lucy-chapar/finder-puck/docs/case-back.png

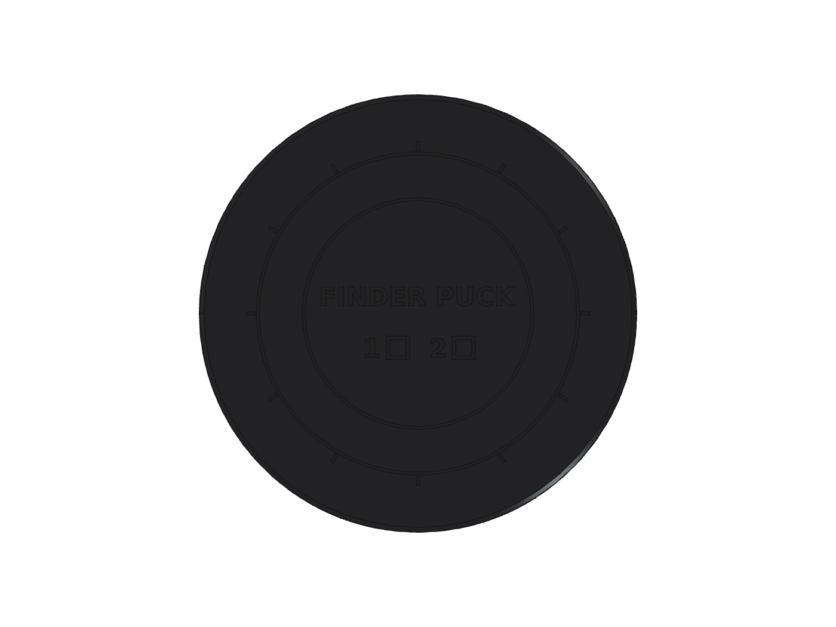
docs/case-back.png
