lucy-chapar/finder-puck/docs/case-face.png

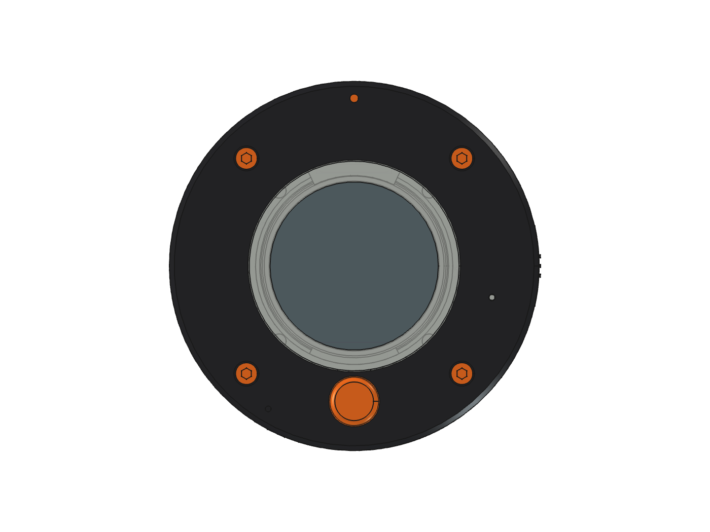
docs/case-face.png
