lucy-chapar/finder-puck/docs/case-shell.png

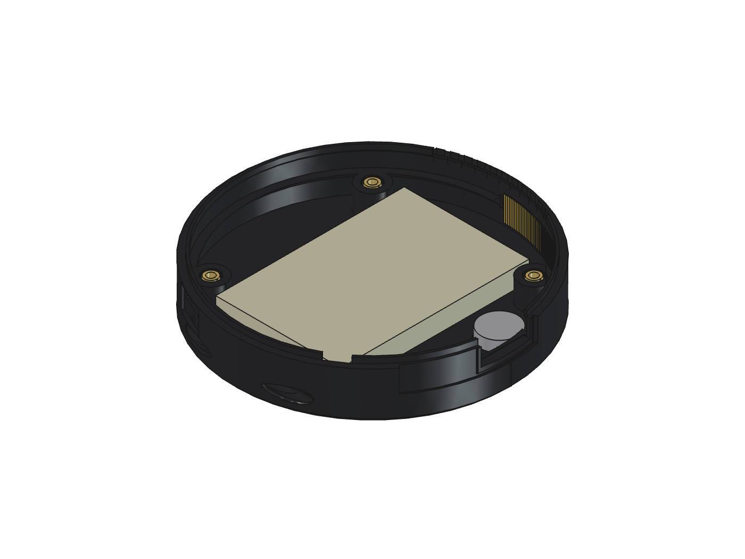
docs/case-shell.png
