lucy-chapar/finder-puck/docs/case-side.png

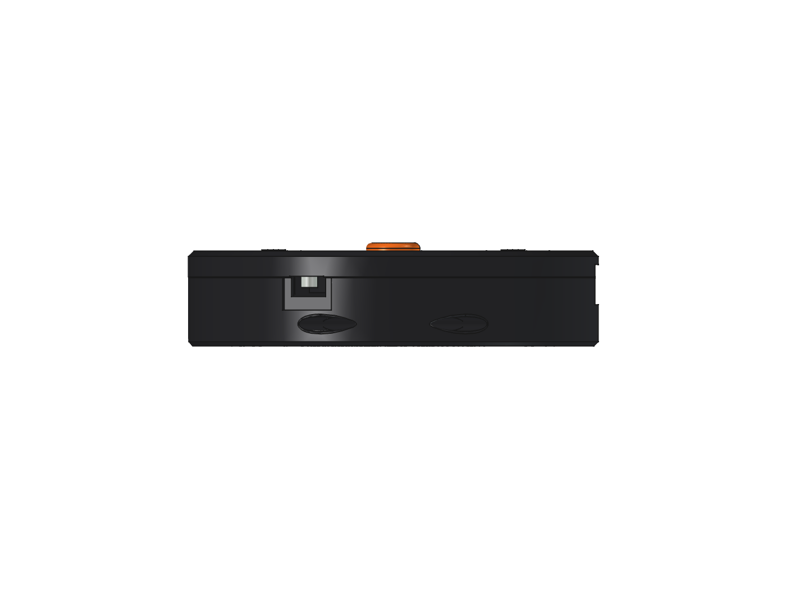
docs/case-side.png
