lucy-chapar/finder-puck/docs/case-stack.png

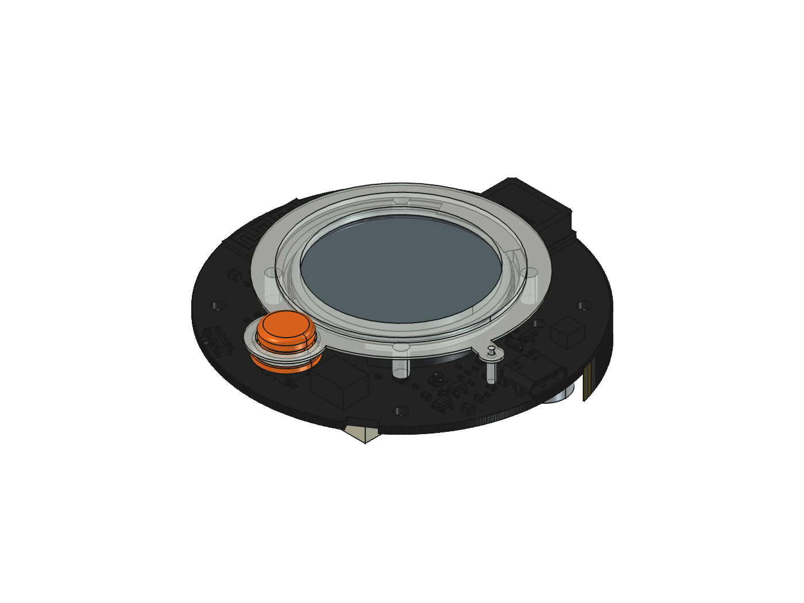
docs/case-stack.png
