lucy-chapar/finder-puck/docs/finder_puck_render_back.png

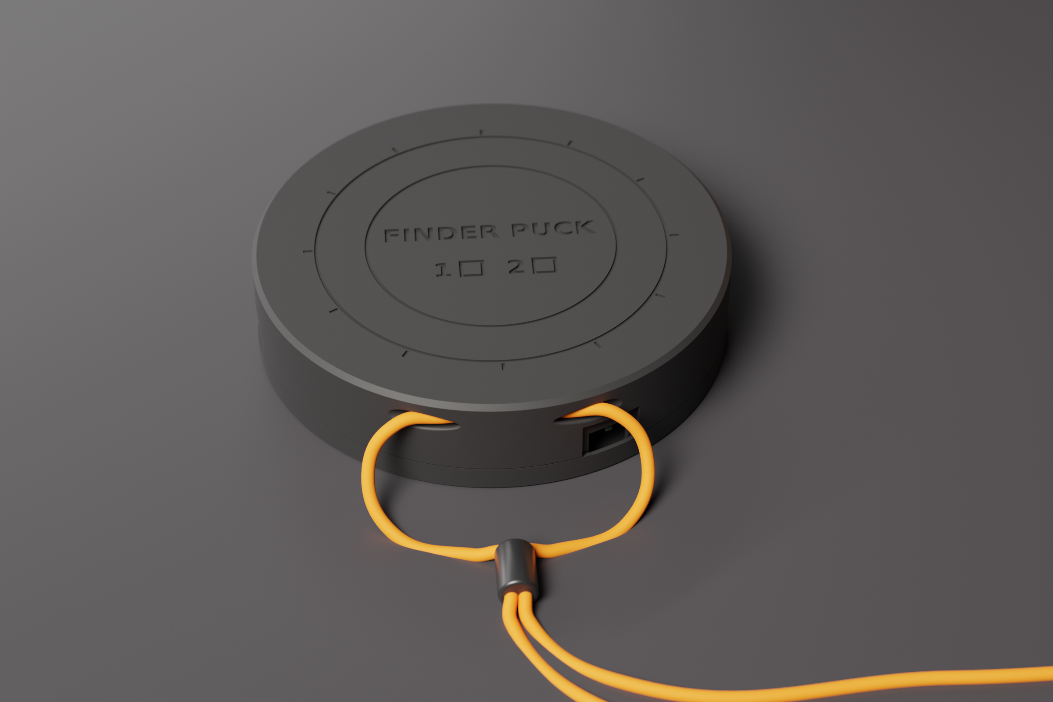
docs/finder_puck_render_back.png
