lucy-chapar/finder-puck/docs/pcb-back.png

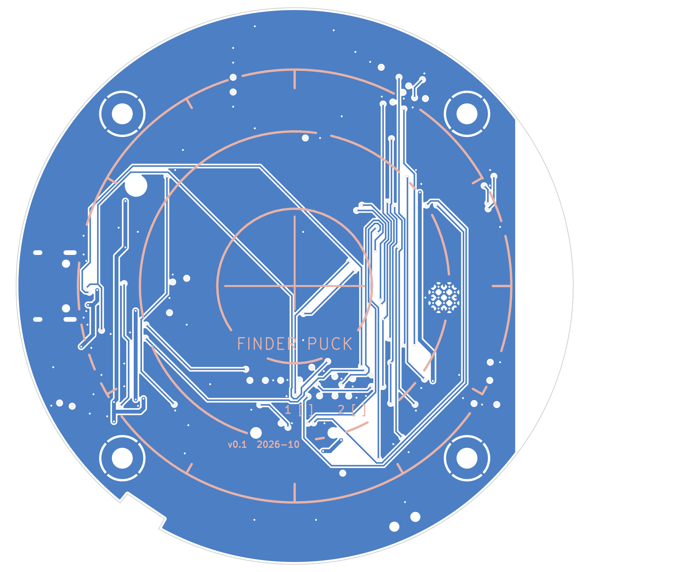
docs/pcb-back.png
