lucy-chapar/finder-puck/fab/finder_puck_bom.csv

Comment | Designator | Footprint | Quantity | Manufacturer part | LCSC Part #
1uF 10V X5R | C1 | C_0402_1005Metric | 1 | Samsung CL05A105KA5NQNC (25 V) | C52923
220nF 16V X7R | C13 | C_0402_1005Metric | 1 | Samsung CL05B224KO5NNNC | C16772
1uF 10V X5R | C17 | C_0603_1608Metric | 1 | Samsung CL10A105KB8NNNC (50 V) | C15849
10uF 10V X5R | C2,C7,C9,C15 | C_0805_2012Metric | 4 | Samsung CL21A106KAYNNNE (25 V) | C15850
100nF 16V X7R | C3,C8,C10,C11,C12,C14,C16,C18,C19,C20,C21,C22 | C_0402_1005Metric | 12 | Samsung CL05B104KO5NNNC | C1525
4.7uF 10V X5R | C4,C5,C6 | C_0603_1608Metric | 3 | Samsung CL10A475KO8NNNC (16 V) | C19666
1N4148W | D1 | D_SOD-123 | 1 | 1N4148W | C81598
Red charge | D2 | LED_0603_1608Metric | 1 | Hubei KENTO KT-0603R | C2286
USB-C | J1 | USB_C_Receptacle_HRO_TYPE-C-31-M-12 | 1 | HRO TYPE-C-31-M-12 | C165948
LiPo 1S | J2 | JST_PH_S2B-PH-SM4-TB_1x02-1MP_P2.00mm_Horizontal | 1 | JST S2B-PH-SM4-TB | C295747
U.FL 915MHz | J4 | U.FL_Hirose_U.FL-R-SMT-1_Vertical | 1 | Hirose U.FL-R-SMT-1(10) | C88373
Vibration motor | J5 | JST_SH_SM02B-SRSS-TB_1x02-1MP_P1.00mm_Horizontal | 1 | JST SM02B-SRSS-TB | C160402
WS2812B-2020 | LED1,LED2,LED3,LED4 | LED_WS2812B-2020_PLCC4_2.0x2.0mm | 4 | Worldsemi WS2812B-2020-V6 | C52917434
AO3400A | Q1,Q2 | SOT-23 | 2 | AOS AO3400A | C20917
AO3401A | Q3 | SOT-23 | 1 | AOS AO3401A | C15127
10k | R1,R2,R16,R17,R23 | R_0402_1005Metric | 5 | UNI-ROYAL 0402WGF1002TCE | C25744
100 | R11 | R_0402_1005Metric | 1 | UNI-ROYAL 0402WGF1000TCE | C25076
27 | R13 | R_0805_2012Metric | 1 | UNI-ROYAL 0805W8F270JT5E | C17594
33 | R18,R19 | R_0402_1005Metric | 2 | UNI-ROYAL 0402WGF330JTCE | C25105
150k | R21,R26 | R_0402_1005Metric | 2 | UNI-ROYAL 0402WGF1503TCE | C25755
220 | R24 | R_0402_1005Metric | 1 | UNI-ROYAL 0402WGF2200TCE | C25091
4.7k | R3,R4 | R_0402_1005Metric | 2 | UNI-ROYAL 0402WGF4701TCE | C25900
5.1k | R5,R6 | R_0402_1005Metric | 2 | UNI-ROYAL 0402WGF5101TCE | C25905
3.3k | R7 | R_0402_1005Metric | 1 | UNI-ROYAL 0402WGF3301TCE | C25890
1k | R8,R14 | R_0402_1005Metric | 2 | UNI-ROYAL 0402WGF1001TCE | C11702
100k | R9,R10,R12,R15,R20,R22,R25 | R_0402_1005Metric | 7 | UNI-ROYAL 0402WGF1003TCE | C25741
Button (top, 5 mm stem) | SW1 | SW_SPST_PTS645 | 1 | C&K PTS645SL50SMTR92LFS | C221877
Power | SW2 | SW_SPDT_PCM12 | 1 | C&K PCM12SMTR | C221841
ESP32-S3-WROOM-1-N8 | U1 | ESP32-S3-WROOM-1 | 1 | Espressif ESP32-S3-WROOM-1-N8 | C2913198
RFM95W-915S2 | U2 | HOPERF_RFM9XW_SMD | 1 | HopeRF RFM95W-915S2
SAM-M10Q | U3 | ublox_SAM-M8Q | 1 | u-blox SAM-M10Q-00B | C5443880
LIS3DH | U4 | LGA-16_3x3mm_P0.5mm_LayoutBorder3x5y | 1 | ST LIS3DHTR | C15134
LIS2MDL | U5 | LGA-12_2x2mm_P0.5mm | 1 | ST LIS2MDLTR | C919695
MCP73831-2-OT | U6 | SOT-23-5 | 1 | Microchip MCP73831T-2ACI/OT | C424093
AP2112K-3.3 | U7 | SOT-23-5 | 1 | Diodes AP2112K-3.3TRG1 | C51118
