lucy-chapar/finder-puck/case/finder_puck_shell.stl

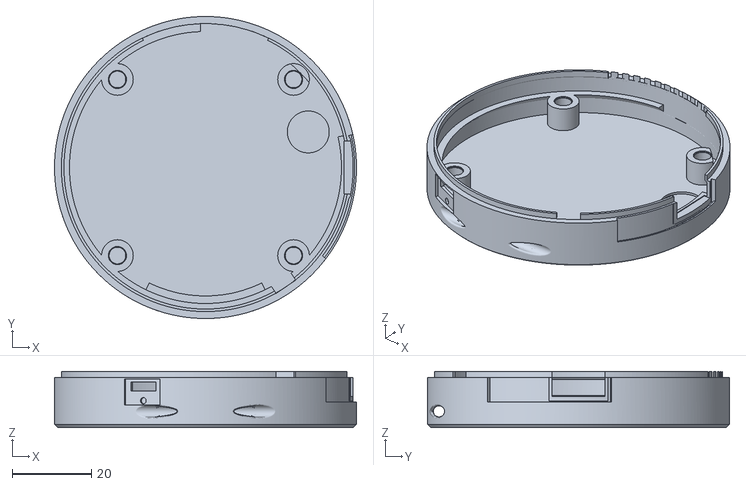
[picture p13: CAD file, 2026-10-23]
case/finder_puck_shell.stl
76.4 x 76.4 x 14.2
