lucy-chapar/finder-puck/mech/finder_puck.step

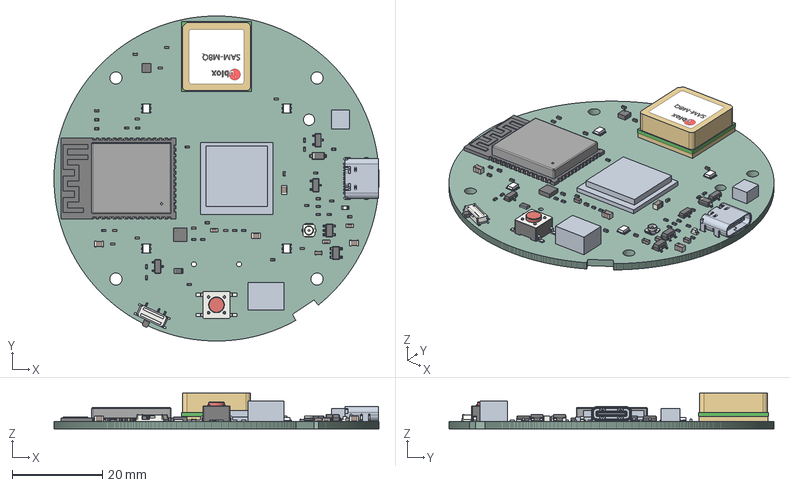
[picture p14: CAD file, 2026-10-23]
mech/finder_puck.step
72.0 x 72.0 x 7.95 mm
finder_puck PCB
