lucy-chapar/finder-puck/case/finder_puck_cap.stl

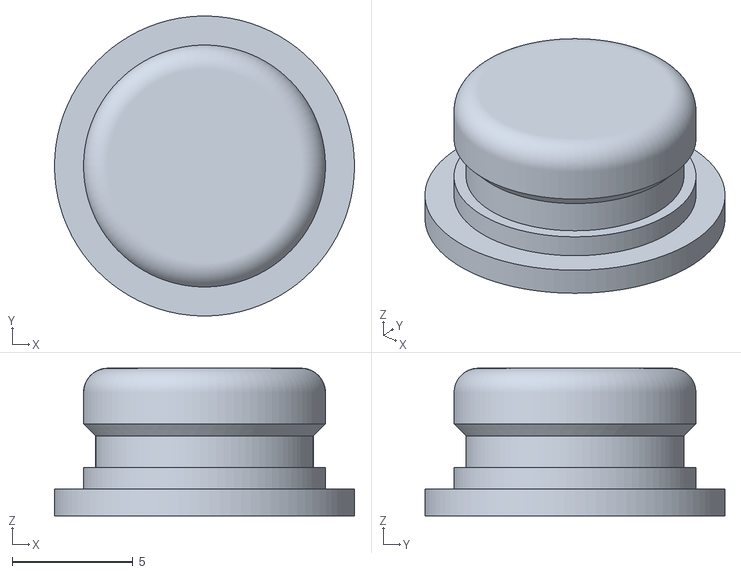
[picture p15: CAD file, 2026-10-23]
case/finder_puck_cap.stl
12.4 x 12.4 x 6.10
