lucy-chapar/finder-puck/case/finder_puck_case.step

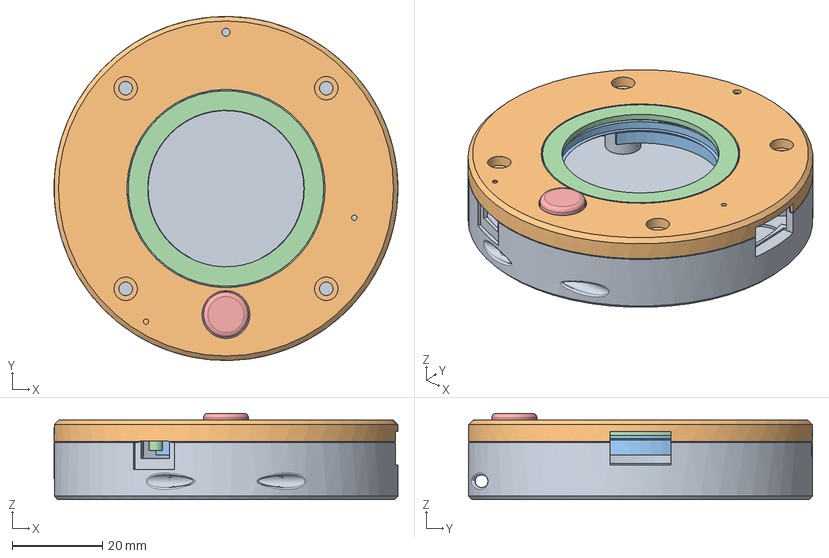
[picture p16: CAD file, 2026-10-23]
case/finder_puck_case.step
76.4 x 76.4 x 19.2 mm
Plate
Ring
Bezel
Cap
