lucy-chapar/finder-puck/case/finder_puck_ring.stl

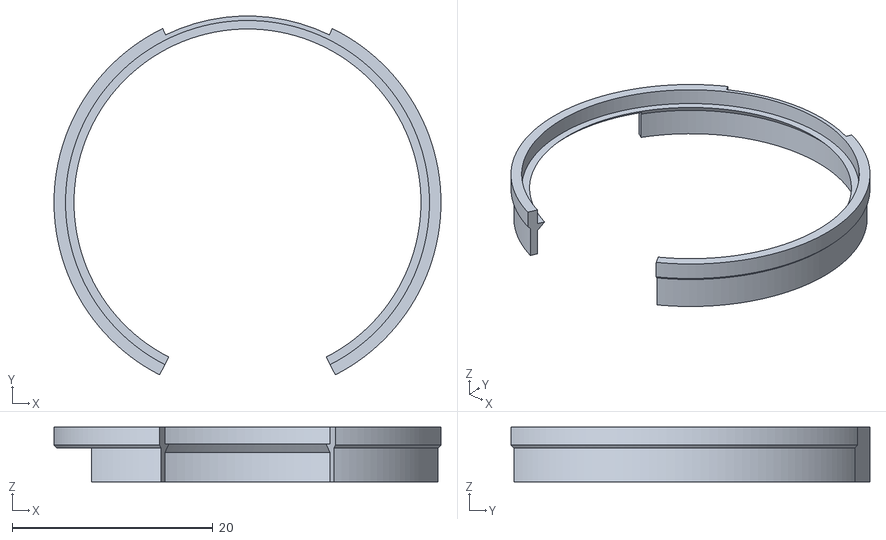
[picture p17: CAD file, 2026-10-23]
case/finder_puck_ring.stl
38.6 x 35.8 x 5.45
