lucy-chapar/finder-puck/case/finder_puck_bezel.stl

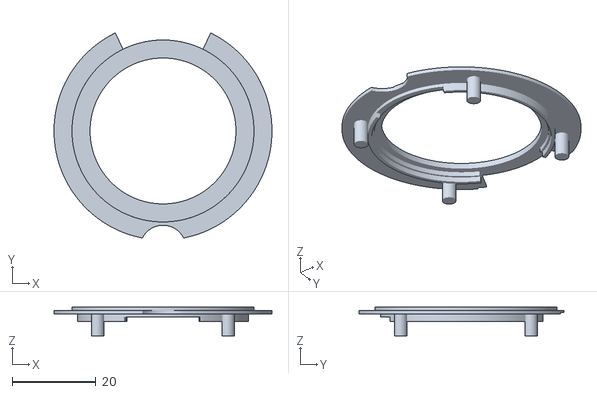
[picture p18: CAD file, 2026-10-23]
case/finder_puck_bezel.stl
52.0 x 48.9 x 6.80
