lucy-chapar/finder-puck/case/finder_puck_plate.stl

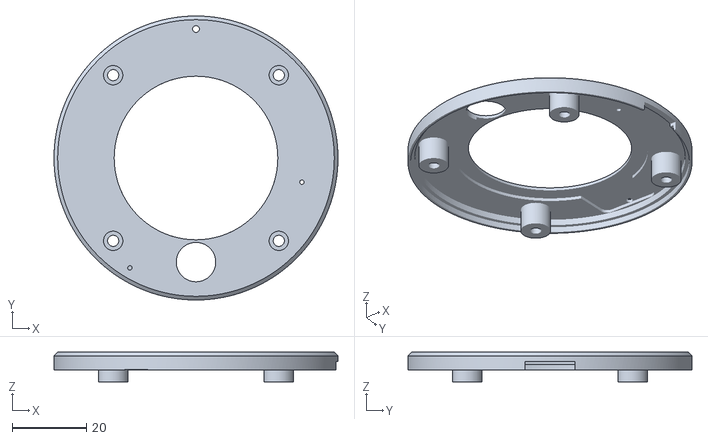
[picture p19: CAD file, 2026-10-23]
case/finder_puck_plate.stl
76.4 x 76.4 x 8.00
