lucy-chapar/finder-puck/(list of files, cad)

Other CAD files:
case/finder_puck_case.FCStd
