lucy-chapar/finder-puck/manual/build_guide.html

Finder Puck

Build Guide

Round-screen puck, through-bolted · Version 0.1.0

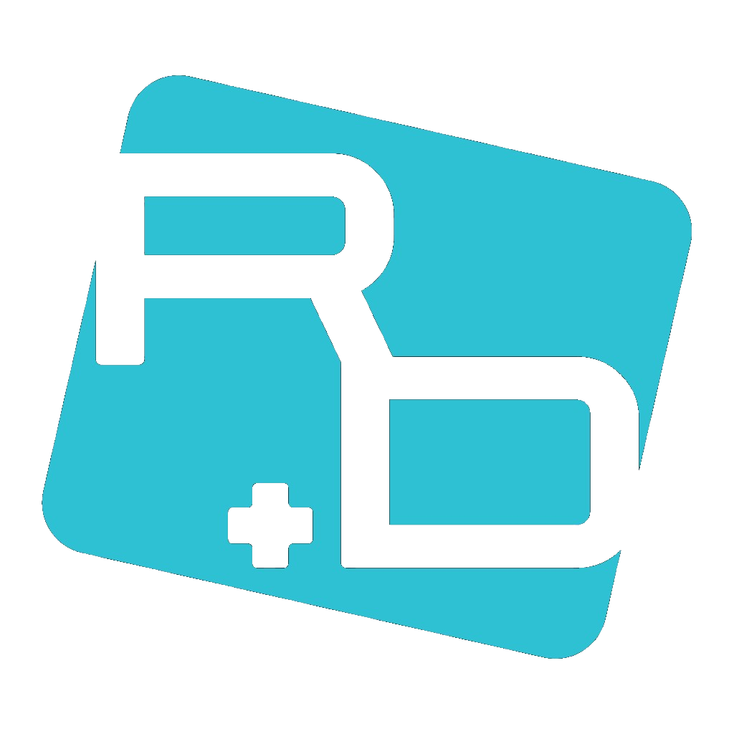
[picture p20: manual/assets/rad-logo.png]


RESEARCH + DESIRE

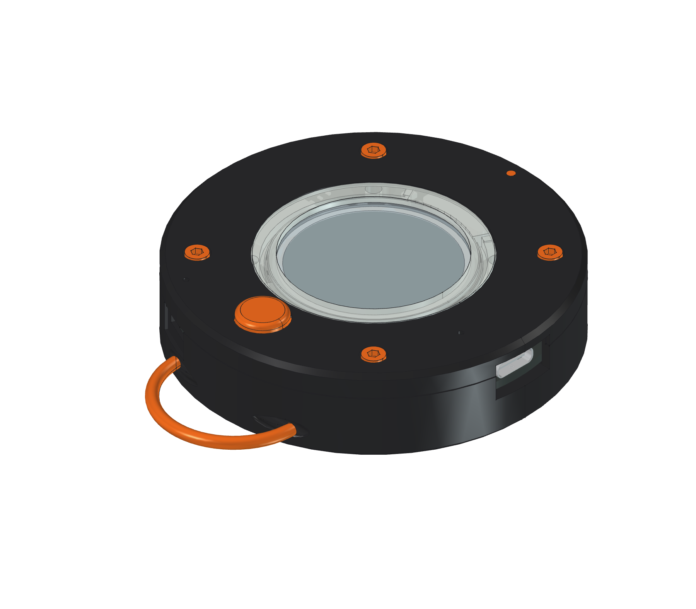
[picture p21: manual/img/cover.png]


Support

support@researchanddesire.com

Design files

README.md in the finder-puck repository

Parts

3D printed

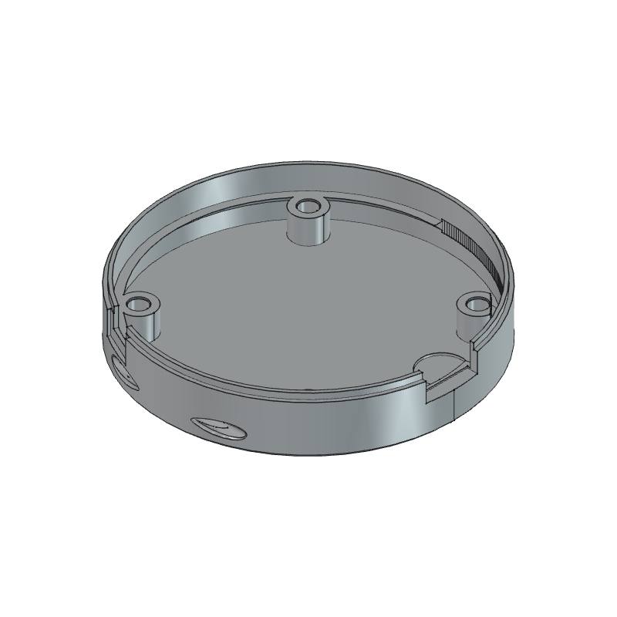
[picture p22: manual/img/card_shell.png]


1×

Shell
black

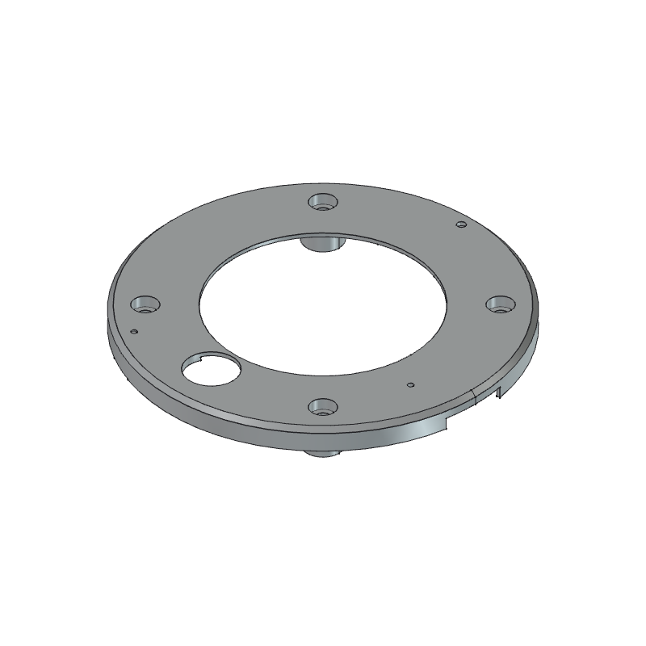
[picture p23: manual/img/card_plate.png]


1×

Plate
black

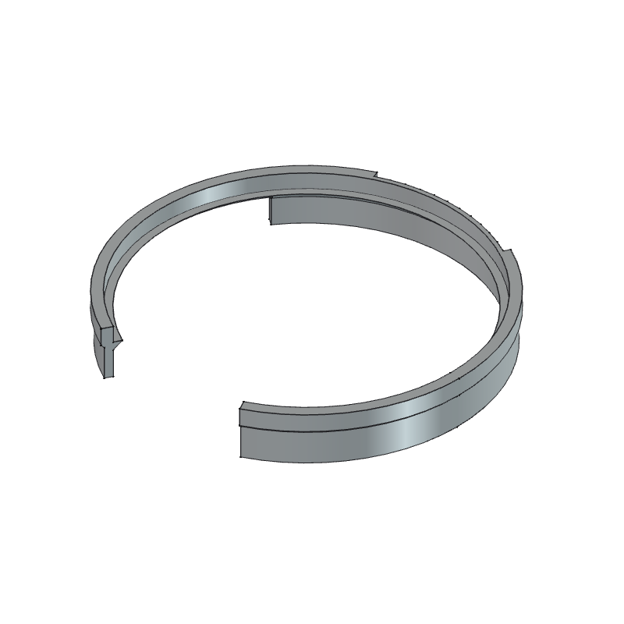
[picture p24: manual/img/card_ring.png]


1×

Ring
black

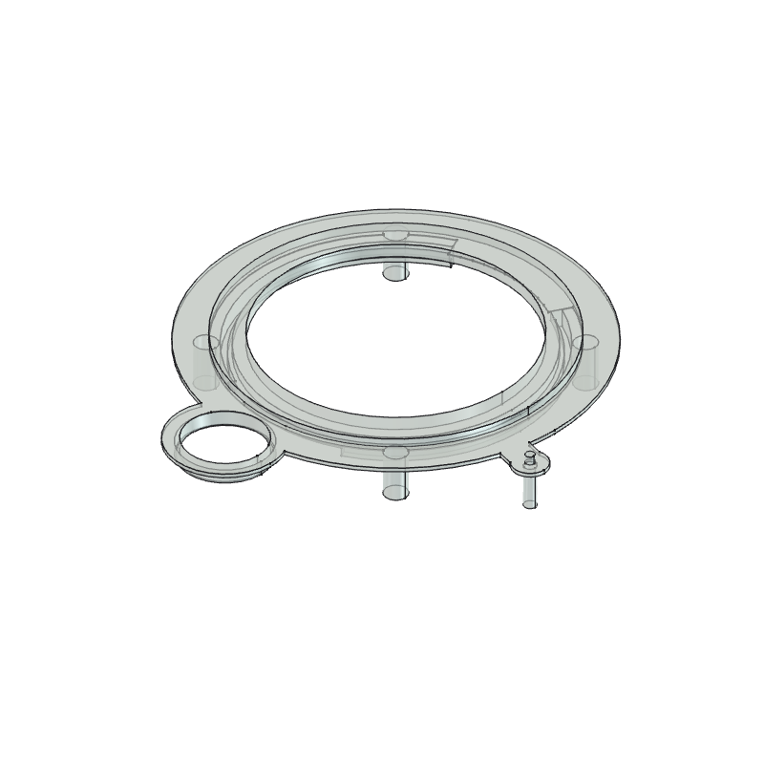
[picture p25: manual/img/card_bezel.png]


1×

Bezel
clear resin

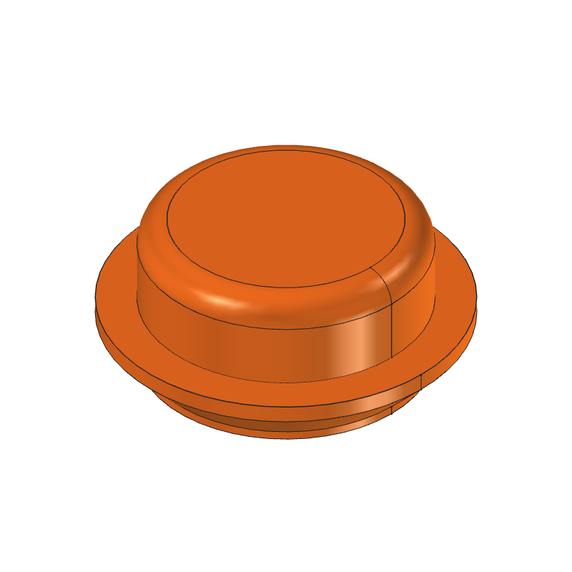
[picture p26: manual/img/card_cap.png]


1×

Button cap
orange

Electronics

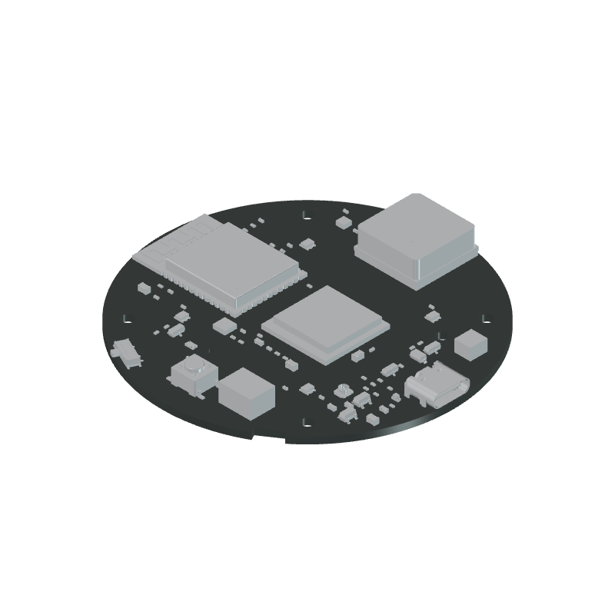
[picture p27: manual/img/card_board.png]


1×

Assembled board
factory-assembled PCB

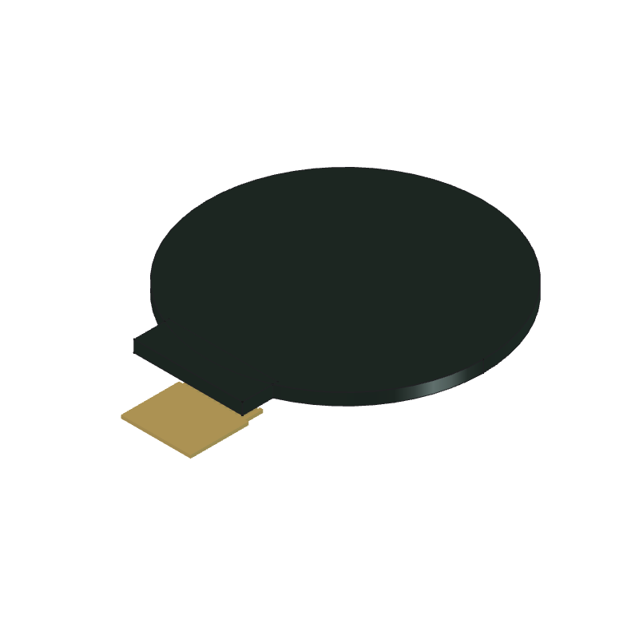
[picture p28: manual/img/card_panel.png]


1×

Round display
1.28″ GC9A01, bare panel

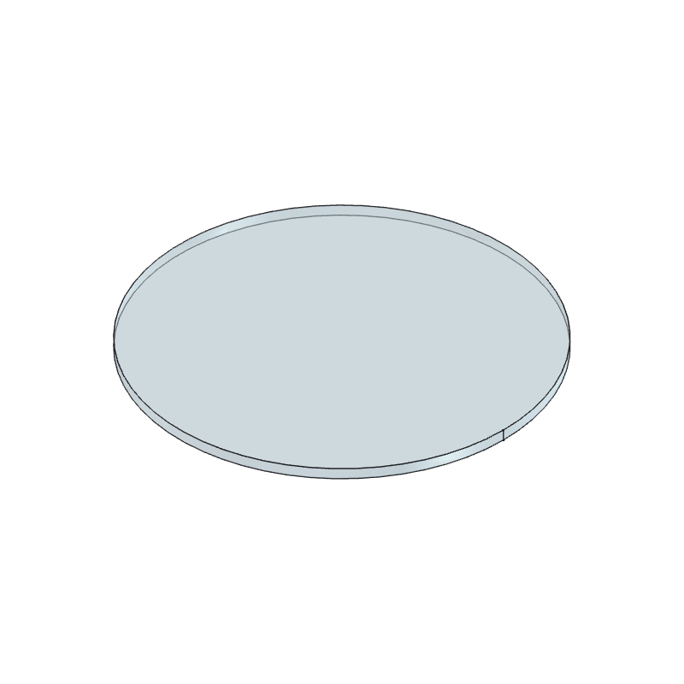
[picture p29: manual/img/card_crystal.png]


1×

Crystal
Ø37.5 × 1.0 mm glass

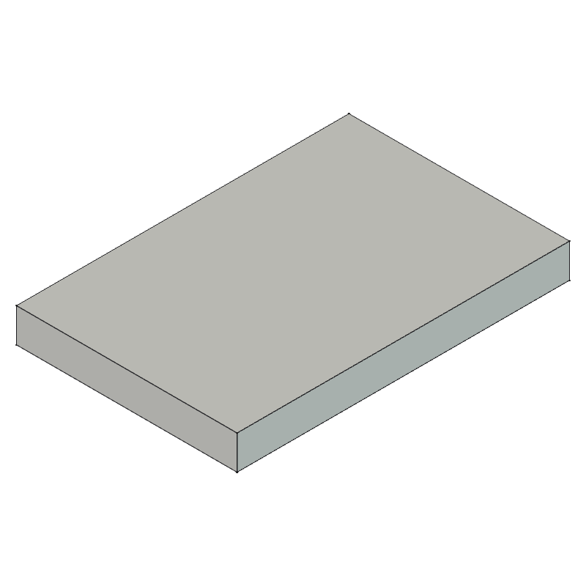
[picture p30: manual/img/card_battery.png]


1×

LiPo cell
503450, 28 AWG leads, JST PH

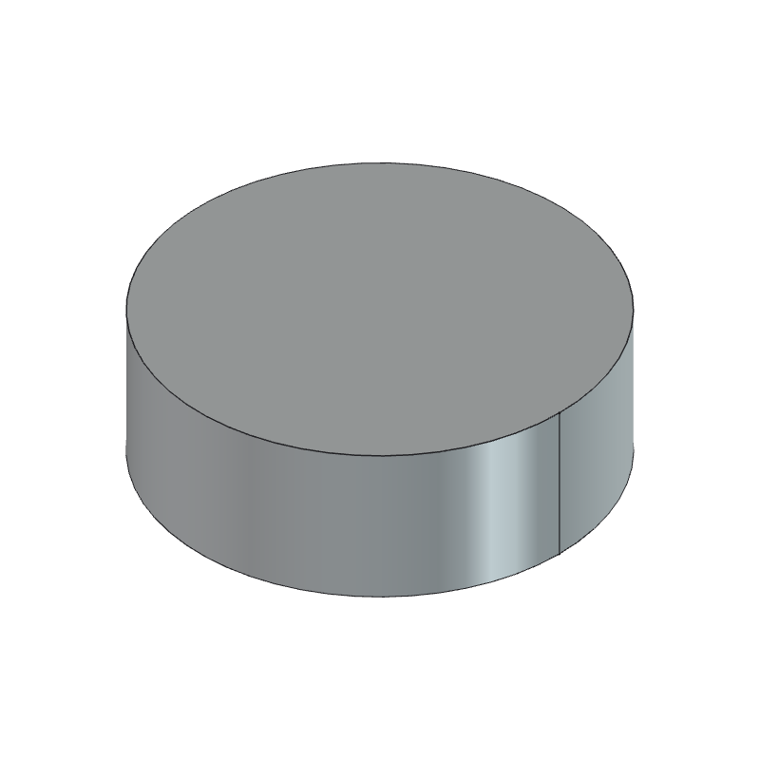
[picture p31: manual/img/card_motor.png]


1×

Vibration motor
Ø10 mm coin, JST SH lead

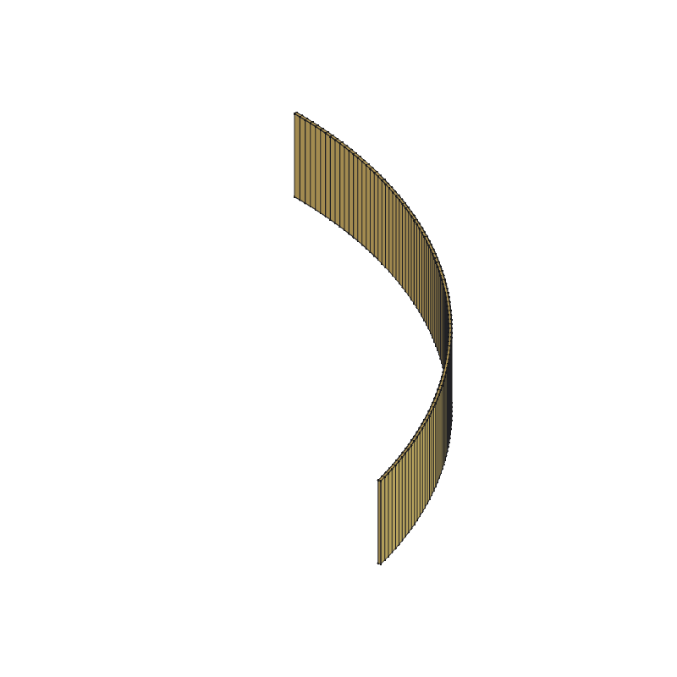
[picture p32: manual/img/card_antenna.png]


1×

915 MHz antenna
adhesive flex 40 × 7 mm (2J 2JF0515P), U.FL

Finder Puck Build Guide · v0.1.0

2



RESEARCH + DESIRE

Parts (continued)

Hardware

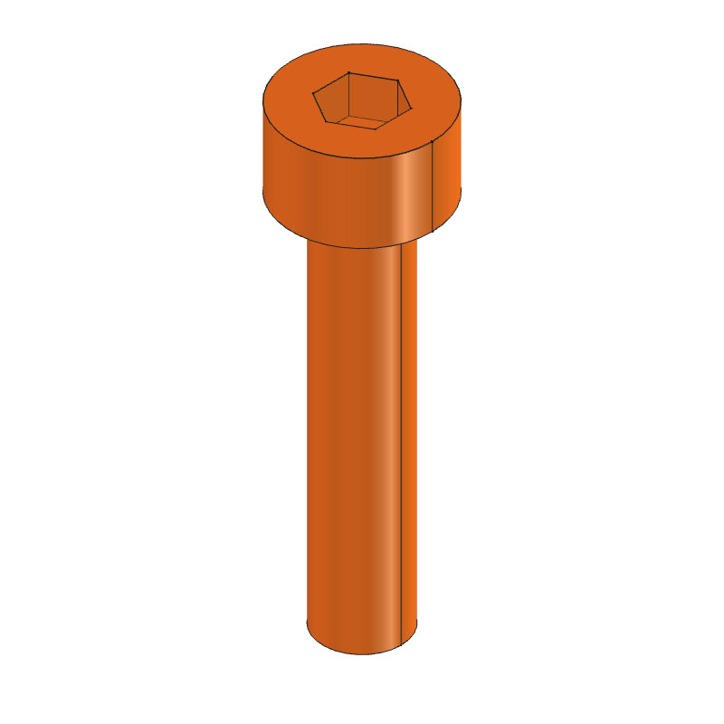
[picture p33: manual/img/card_bolt.png]


4×

Bolt M2.5 × 12
socket cap, aluminium (non-magnetic)

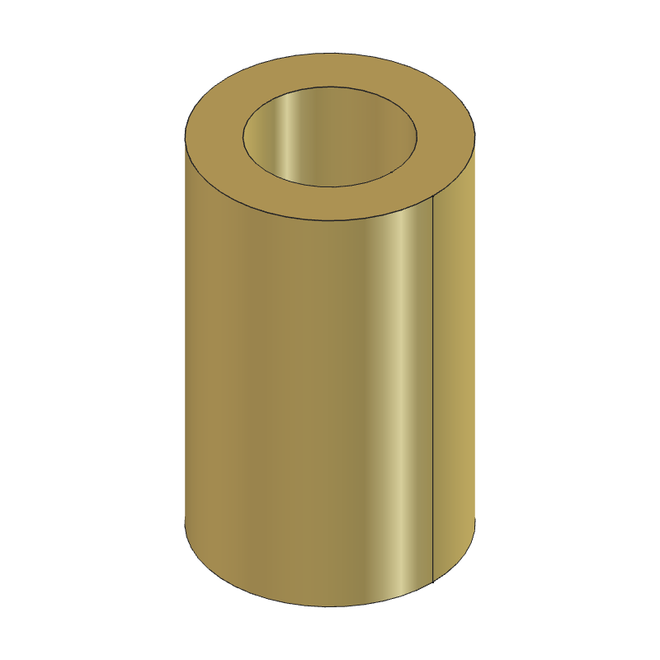
[picture p34: manual/img/card_insert.png]


4×

Heat-set insert M2.5
Ruthex RX-M2.5x5.7, 4 mm hole

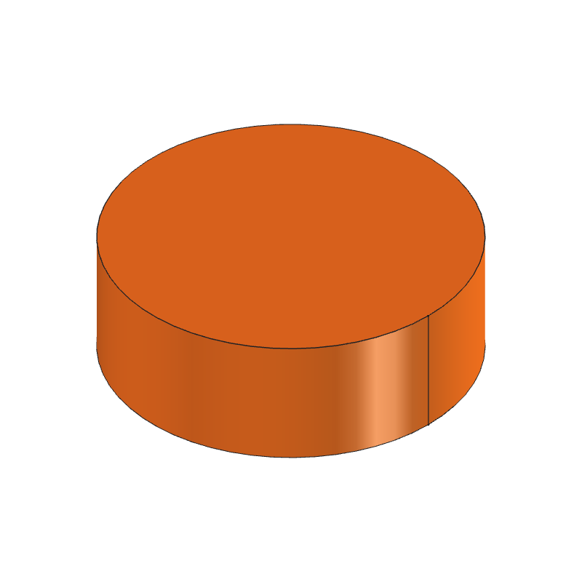
[picture p35: manual/img/card_index.png]


1×

Index stub
orange 1.75 mm filament, trim flush

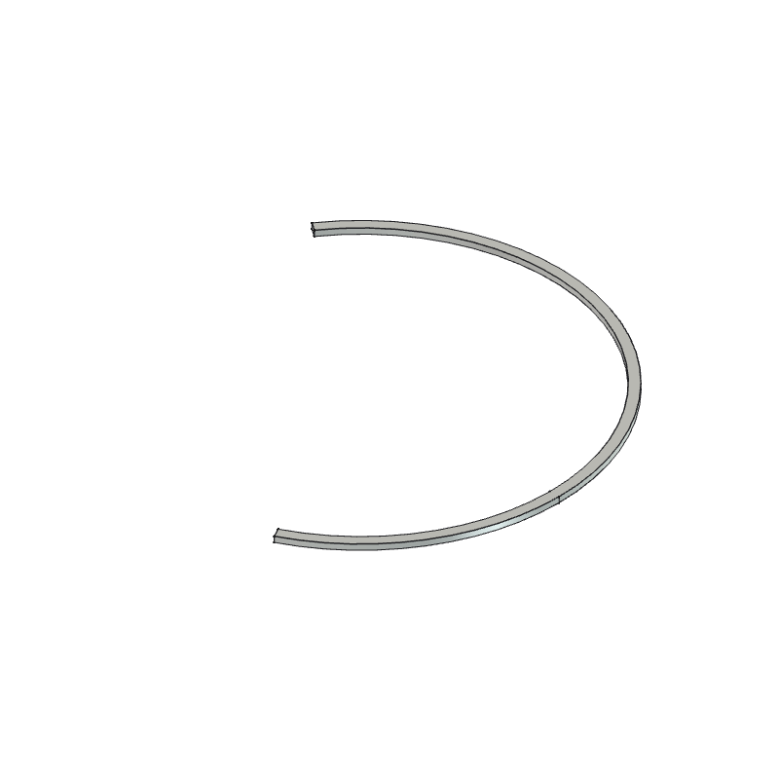
[picture p36: manual/img/card_foamring.png]


1×

Foam ring
0.5 mm, Ø36.3–38 mm, open 10 to 5 o'clock

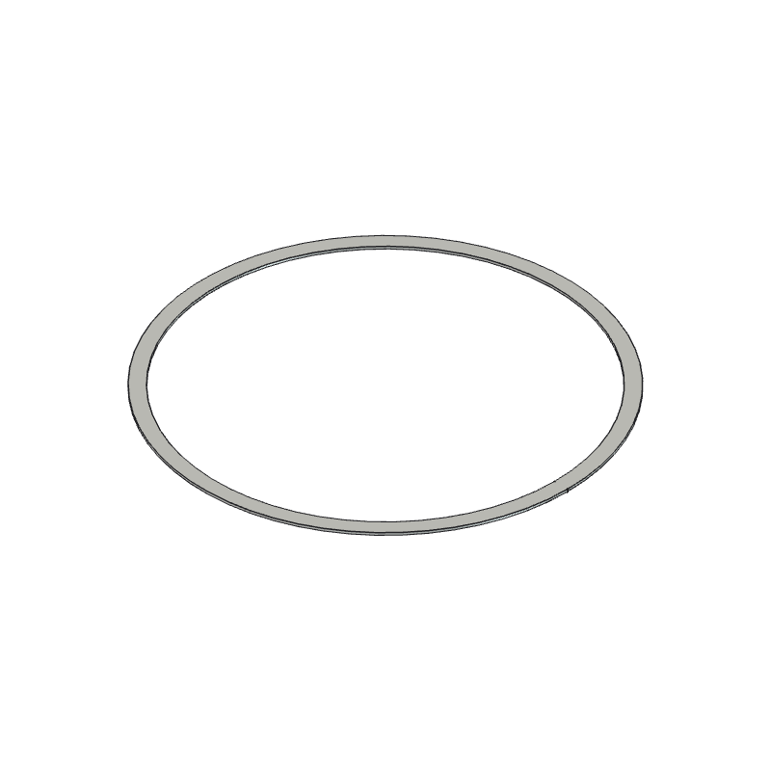
[picture p37: manual/img/card_gasket.png]


1×

Gasket
0.3 mm foam, Ø32.5–35 mm

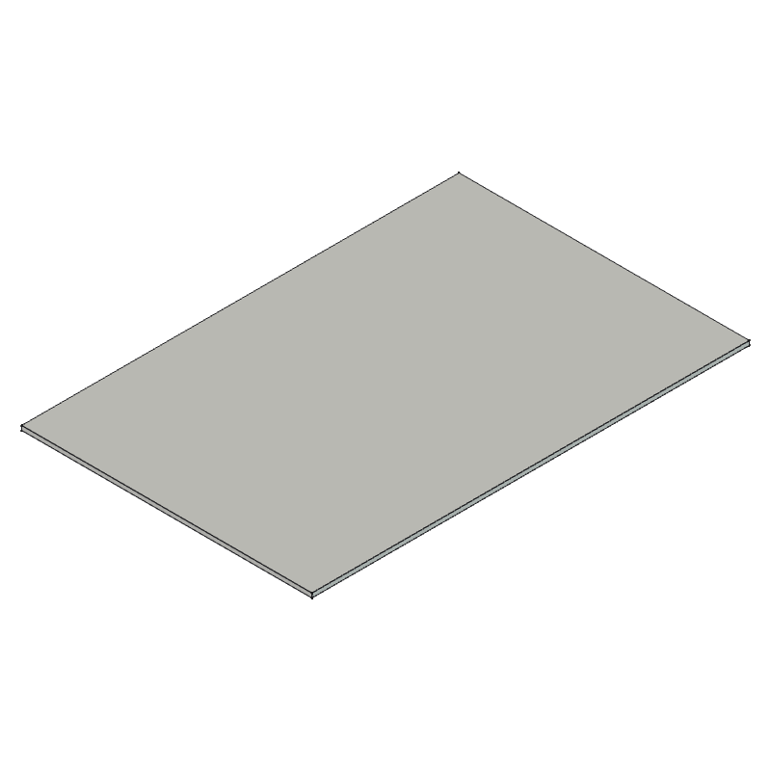
[picture p38: manual/img/card_pad.png]


1×

Battery pad
0.5 mm foam, 34 × 50 mm

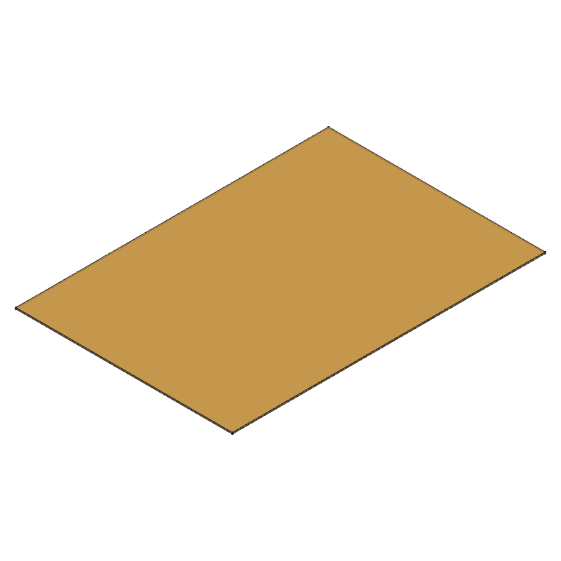
[picture p39: manual/img/card_sheet.png]


1×

Insulation sheet
0.2 mm Kapton or PET, 36 × 52 mm

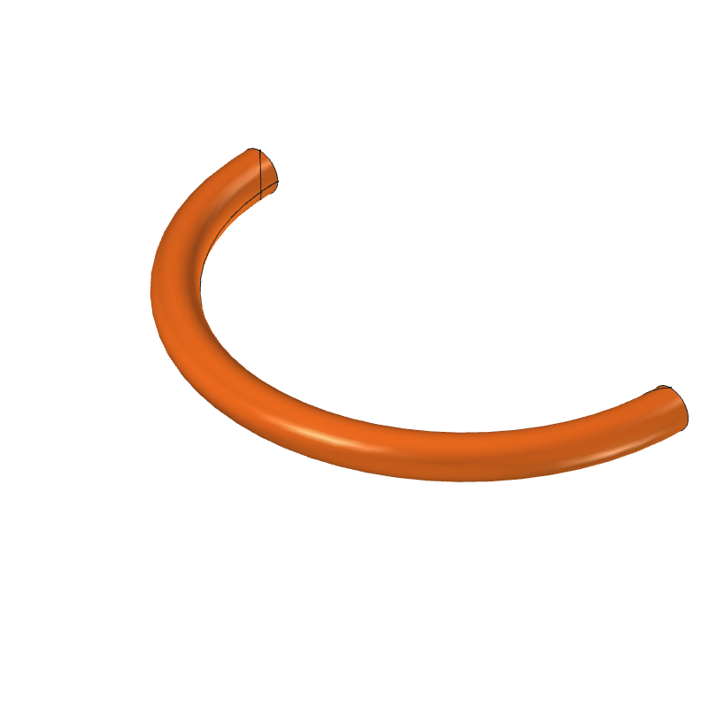
[picture p40: manual/img/card_cord.png]


1×

Cord
Ø2.5 mm, 300 mm

Finder Puck Build Guide · v0.1.0

3



RESEARCH + DESIRE

Tools

Required

Soldering iron, fine tip

Solder and flux

Tweezers

Hex key 2 mm

Multimeter

Super glue

USB-C cable and a computer

Recommended

Magnifier

Isopropyl alcohol

Kapton tape

Paint pen

Finder Puck Build Guide · v0.1.0

4



RESEARCH + DESIRE

Before you start

Print

Shell upright, ring upside down (top face on the bed), plate face down, cap pocket down; 0.2 mm layers, four walls. Print the bezel in clear resin: its flange cannot be bridged and its fits are 0.25 mm. Print a hole coupon before trusting the insert holes.

Panel first

Buy two panels. Before anything else, look at the flex: after it folds under the glass, pin 1 must land on the 3 o'clock side of the board's pads. If yours is mirrored, the board needs regenerating with FPC_PIN1_RIGHT flipped, not a different fold.

Battery

The cell is live whatever the switch does. It is plugged in only after the soldering (step 9), and the insulation sheet goes on it before the board. Check the lead's polarity with the meter; many cells are wired the other way round.

Iron

220 °C for the inserts, 320 °C with plenty of flux for the 0.7 mm flex. Clean with alcohol.

Compass

Keep steel away from the compass: aluminium bolts only, no steel screws or magnets near the puck.

Finder Puck Build Guide · v0.1.0

5



RESEARCH + DESIRE

1



1×

Shell



4×

Heat-set insert M2.5

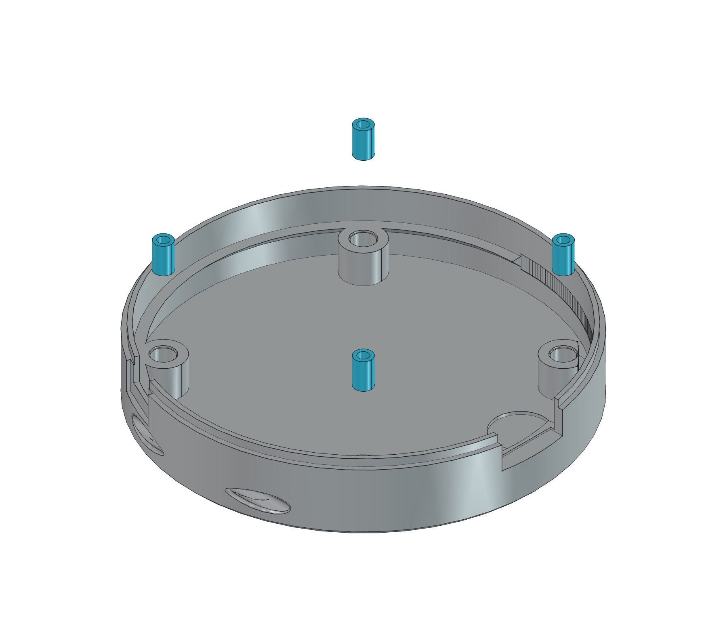
[picture p41: manual/img/s01.png]


Heat-set with the iron at 220 °C until the insert is flush with the boss.

Finder Puck Build Guide · v0.1.0

6



RESEARCH + DESIRE

2



1×

Vibration motor



1×

915 MHz antenna

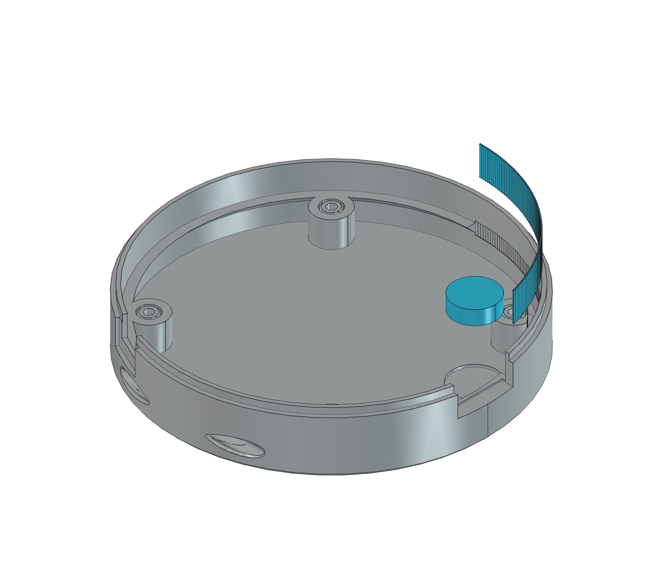
[picture p42: manual/img/s02.png]


Motor in the pocket at 2 o'clock, lead up. Peel the flex antenna and press it to the inside of the wall between 12 and 3 o'clock, cable end at 3 o'clock; run the pigtail along the floor to the notch at 5 o'clock.

Finder Puck Build Guide · v0.1.0

7



RESEARCH + DESIRE

3



1×

Battery pad



1×

LiPo cell



1×

Insulation sheet

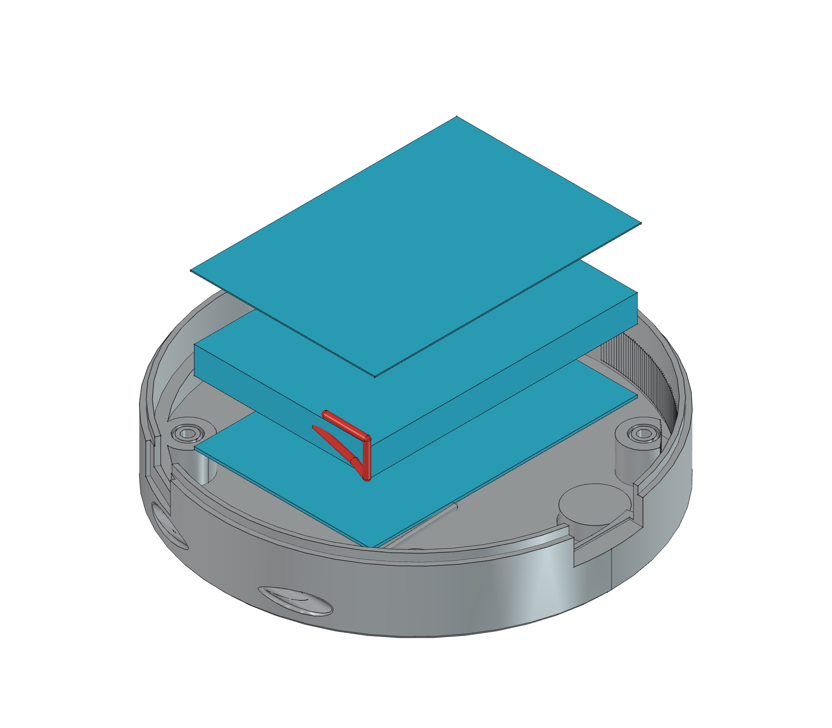
[picture p43: manual/img/s03.png]


Pad first, the cell on it with its lead toward 5 o'clock, then the insulation sheet on top of the cell. Do not pinch the lead.

Finder Puck Build Guide · v0.1.0

8



RESEARCH + DESIRE

4



1×

Assembled board

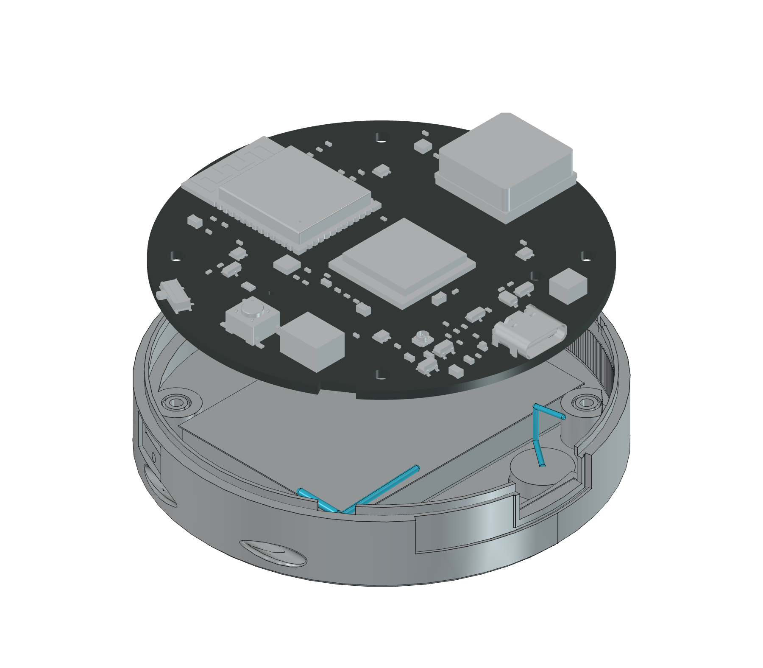
[picture p44: manual/img/s04.png]


Feed the motor lead up through its hole, the battery lead and the antenna pigtail up through the 6 mm notch at 5 o'clock, then lower the board onto the rim.

Finder Puck Build Guide · v0.1.0

9



RESEARCH + DESIRE

5

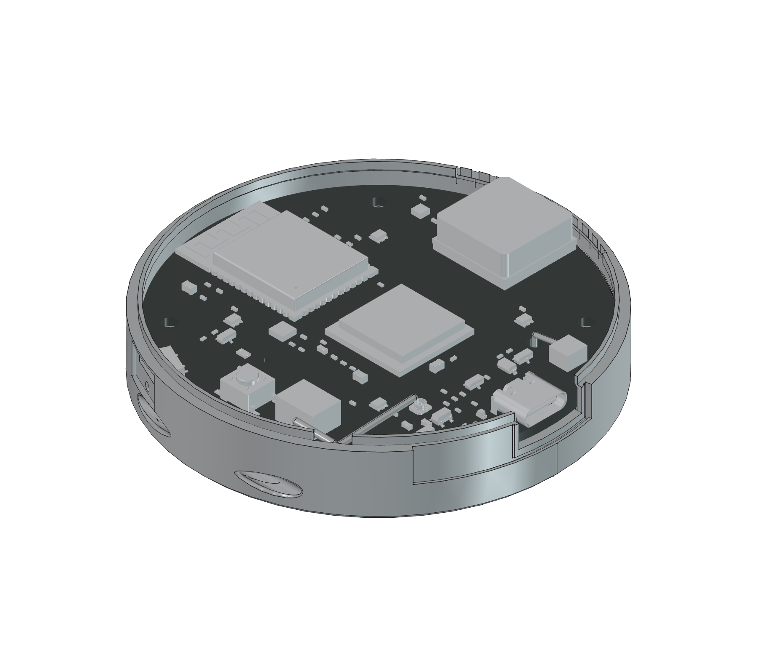
[picture p45: manual/img/s05.png]


Plug the motor into its socket and click the pigtail onto the antenna socket. The battery stays unplugged until the panel is soldered.

Finder Puck Build Guide · v0.1.0

10



RESEARCH + DESIRE

6



1×

Foam ring



1×

Ring

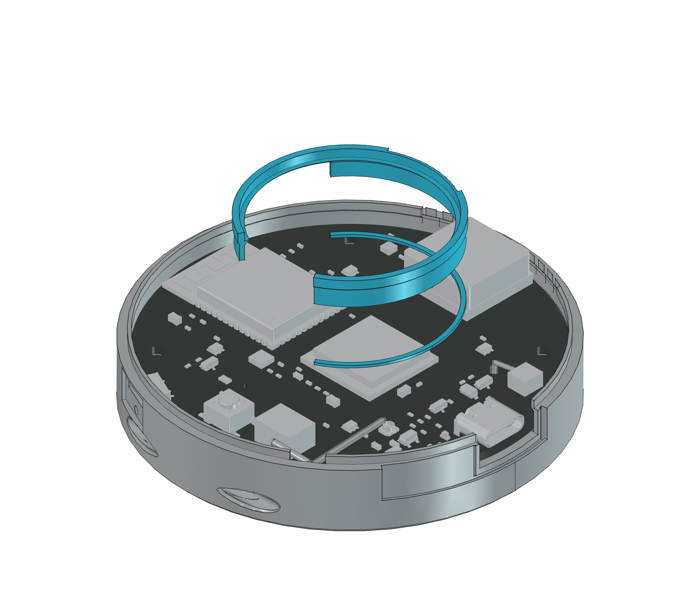
[picture p46: manual/img/s06.png]


The opening in the ring faces the button (6 o'clock); the solder pads stay reachable through it.

Finder Puck Build Guide · v0.1.0

11



RESEARCH + DESIRE

7



1×

Round display

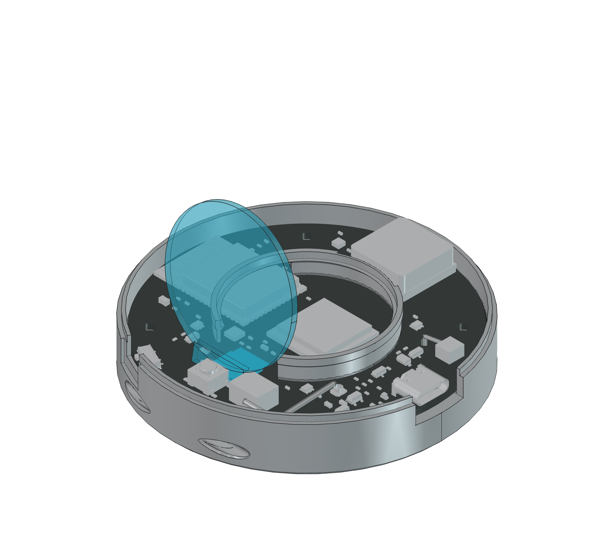
[picture p47: manual/img/s07.png]


Stand the panel on its chin and lay the flex on the pads: pin 1 on the right as you look from the button side (use the loupe). Tack both ends, solder the 12 fingers, clean with alcohol.

Finder Puck Build Guide · v0.1.0

12



RESEARCH + DESIRE

8

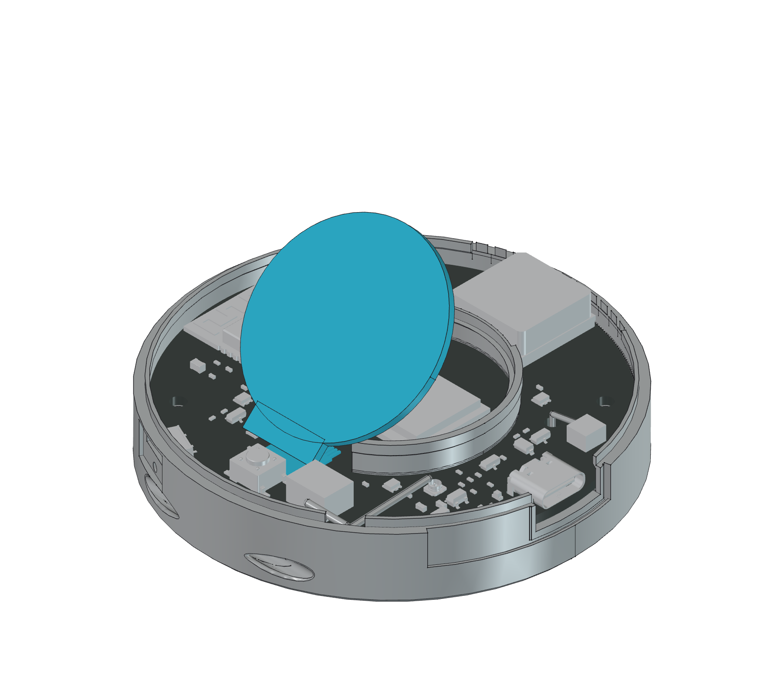
[picture p48: manual/img/s08.png]


Fold the panel down onto the ledge. The flex bends once, under the glass; never crease it.

Finder Puck Build Guide · v0.1.0

13



RESEARCH + DESIRE

9

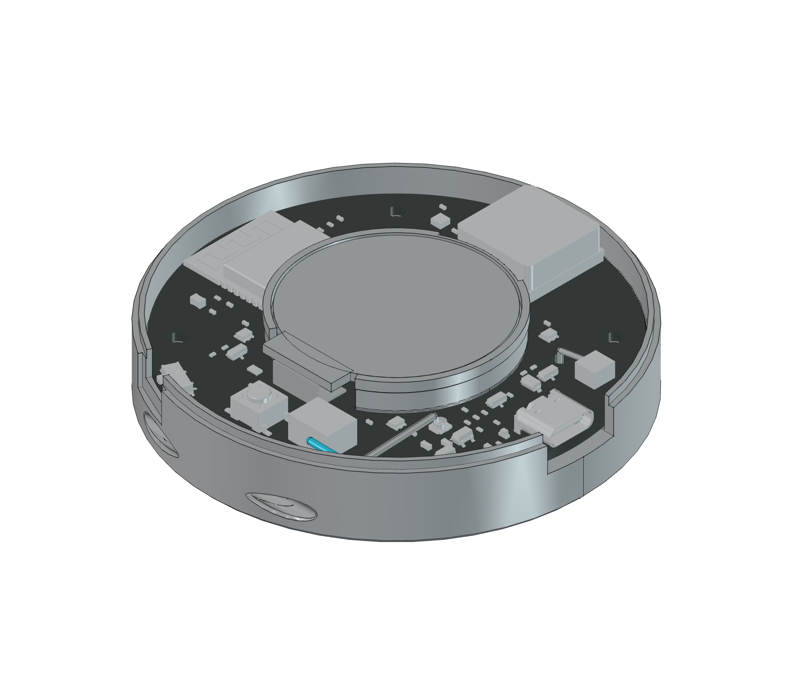
[picture p49: manual/img/s09.png]


Now plug in the battery. Check the lead with the meter first: + is marked on the board next to the socket.

Finder Puck Build Guide · v0.1.0

14



RESEARCH + DESIRE

10



1×

Gasket



1×

Crystal

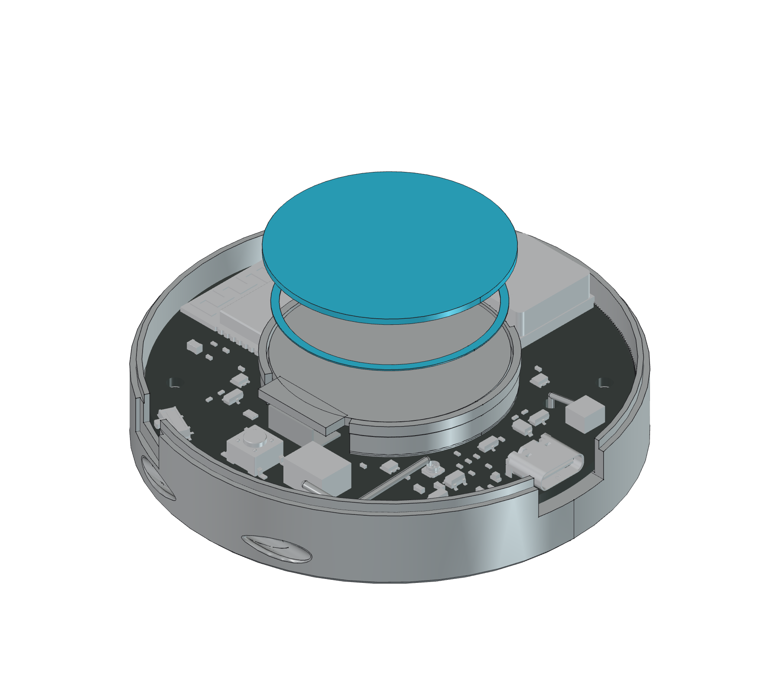
[picture p50: manual/img/s10.png]


Blow the dust off the glass first. The crystal rests on the ring, not on the panel.

Finder Puck Build Guide · v0.1.0

15



RESEARCH + DESIRE

11



1×

Bezel

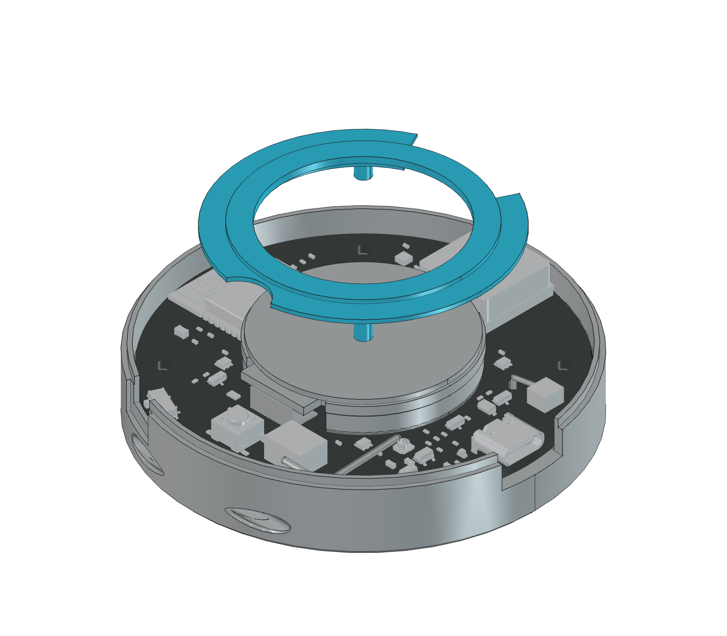
[picture p51: manual/img/s11.png]


The four light pipes drop over the LEDs; the bezel seats over the ring and holds the crystal.

Finder Puck Build Guide · v0.1.0

16



RESEARCH + DESIRE

12



1×

Button cap

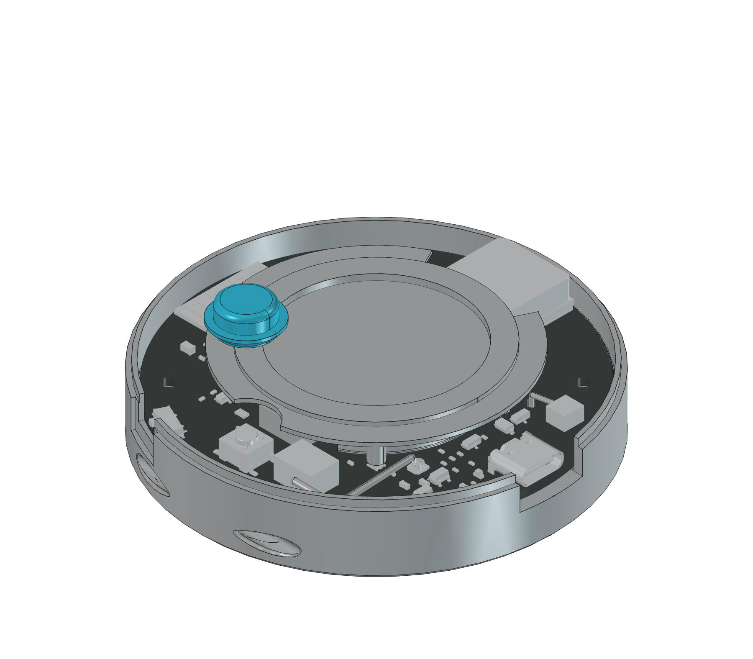
[picture p52: manual/img/s12.png]


The square pocket in the cap fits the switch stem. A dot of glue in the pocket keeps it on.

Finder Puck Build Guide · v0.1.0

17



RESEARCH + DESIRE

13

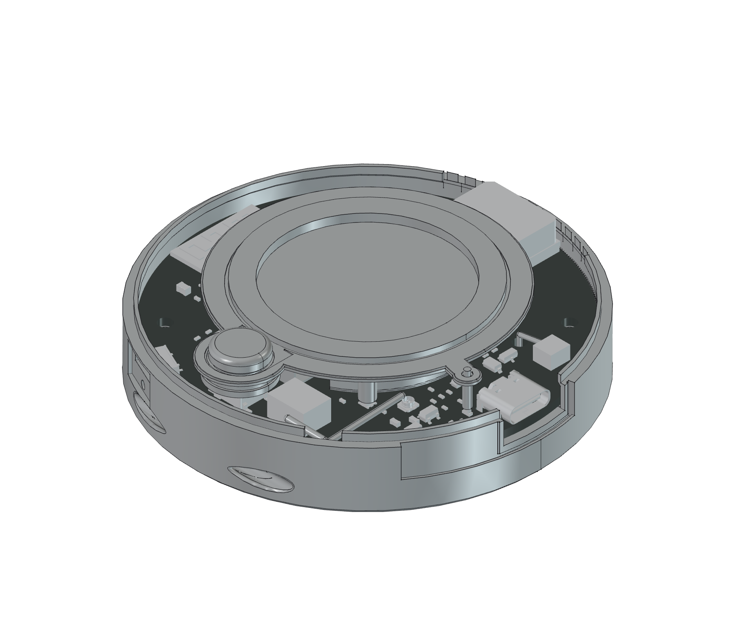
[picture p53: manual/img/s13.png]


Test before the plate goes on: plug in USB-C, flash the firmware, slide the switch toward the dot. The screen lights, the four LEDs strobe when you press the button, the motor ticks. Switch off again.

Finder Puck Build Guide · v0.1.0

18



RESEARCH + DESIRE

14



1×

Plate



4×

Bolt M2.5 × 12

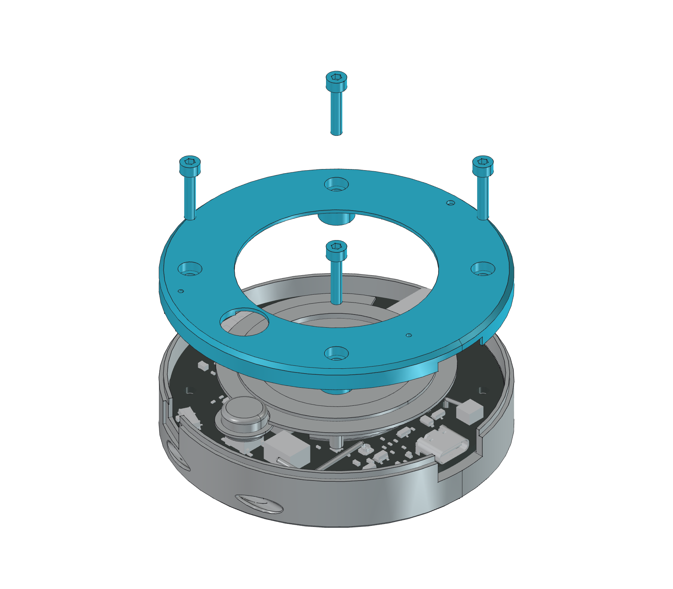
[picture p54: manual/img/s14.png]


Lower the plate over the bezel and cap, then the four bolts. Hand-tight only, in a cross: aluminium sockets strip.

Finder Puck Build Guide · v0.1.0

19



RESEARCH + DESIRE

15



1×

Index stub



1×

Cord

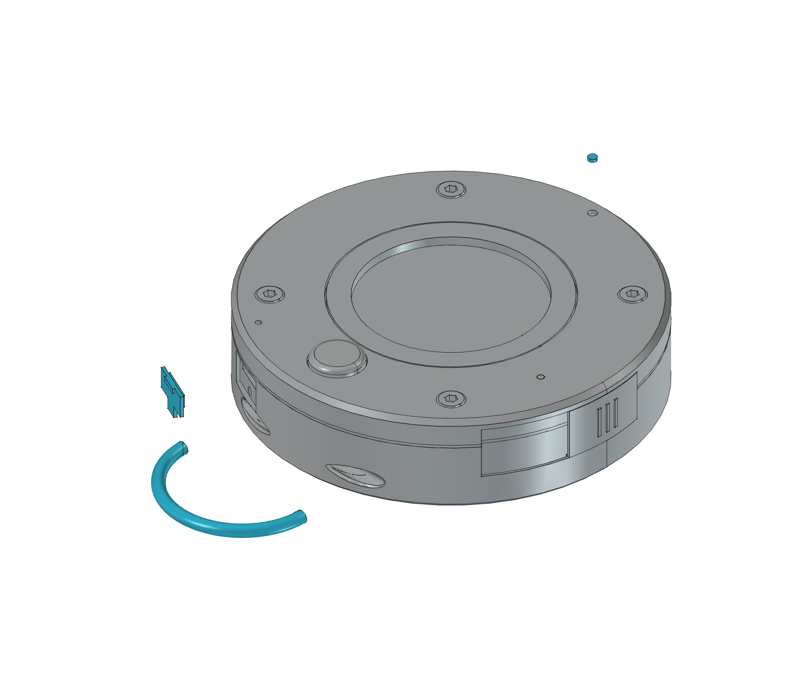
[picture p55: manual/img/s15.png]


Glue the orange stub into the hole at 12 o'clock and trim it flush. Thread the cord in one mouth and out the other, then knot it.

Finder Puck Build Guide · v0.1.0

20



RESEARCH + DESIRE

16

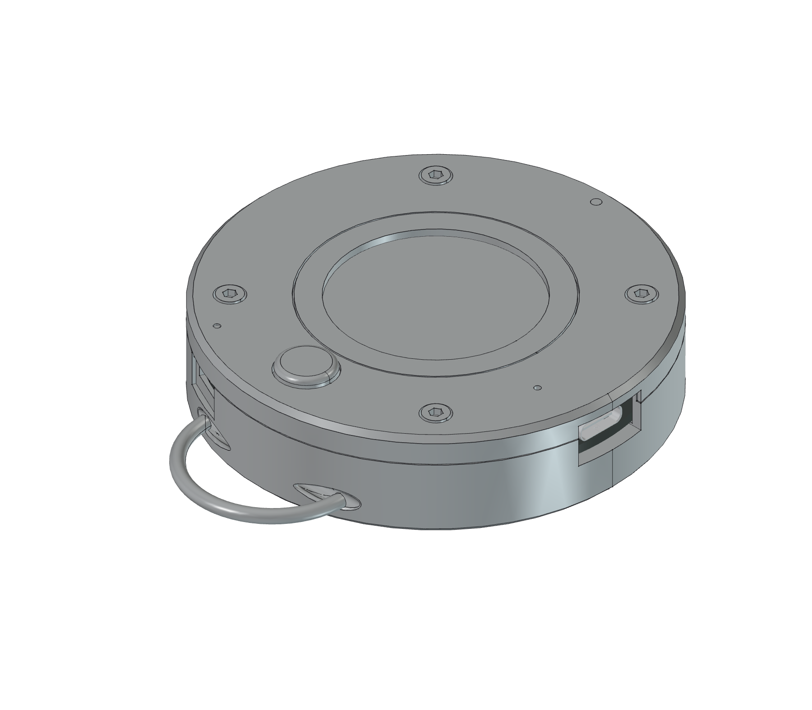
[picture p56: manual/img/s16.png]


Slide the switch toward the dot to switch on. Charge through USB-C with the puck off; the pinhole LED goes out when the cell is full. Mark this puck 1 or 2 in the field on the back with the paint pen.

Finder Puck Build Guide · v0.1.0

21



RESEARCH + DESIRE

Done

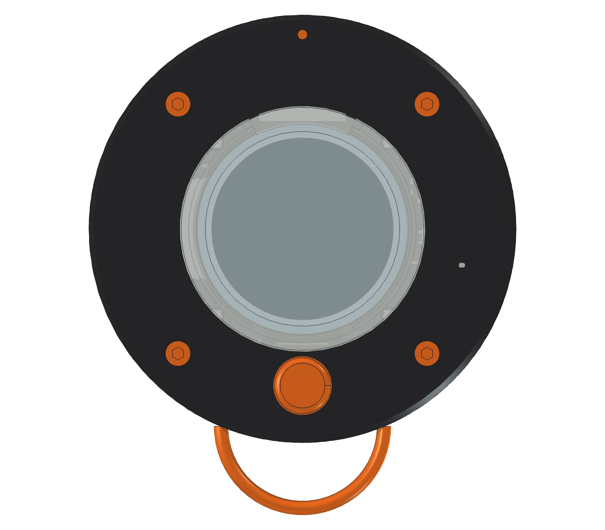
[picture p57: manual/img/face.png]


The orange dot is 12 o'clock. The arrow points at your partner and the blip sits at their range on the rings; the scale (50 m, 500 m, 5 km) is printed at 3 o'clock. While you hold the button the screen tells you what letting go will do.

The button

Press

Beacon on or off for 60 s: both pucks strobe so your friend can spot you.

Double press

Vibration on or off (remembered).

Hold 2 s, release

Pairing mode. Hold again to cancel.

Hold 5 s, release

Compass calibration: turn the puck through a slow figure of eight.

Finder Puck Build Guide · v0.1.0

22



RESEARCH + DESIRE



RESEARCH + DESIRE

Finder Puck Build Guide

Round-screen puck, through-bolted · Version 0.1.0

Support

support@researchanddesire.com

Design files

README.md in the finder-puck repository

Open hardware. The design files (KiCad board, FreeCAD case, this guide) are generated from scripts; see the README before changing anything by hand.

Finder Puck Build Guide · v0.1.0

23



RESEARCH + DESIRE
