lucy-chapar/finder-puck/docs/finder_puck_build_guide.pdf

# Finder Puck

# Build Guide

## Round-screen puck, through-bolted · Version 0.3.0

RESEARCH + DESIRE

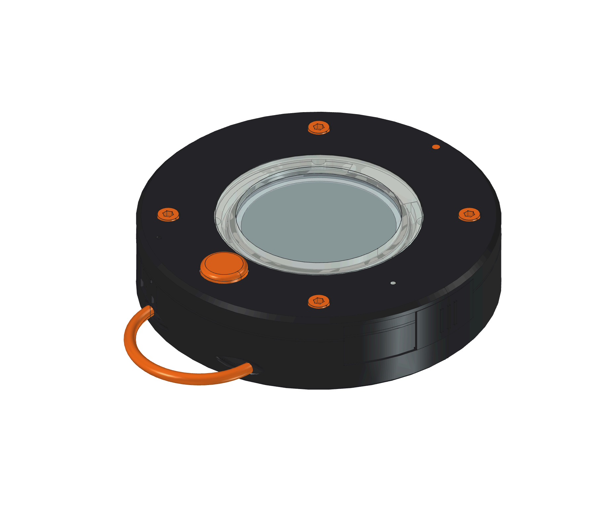
[picture p58: figure]

Support

### support@researchanddesire.com

Design files
README.md in the finder-puck repository

# Parts

# 3D printed

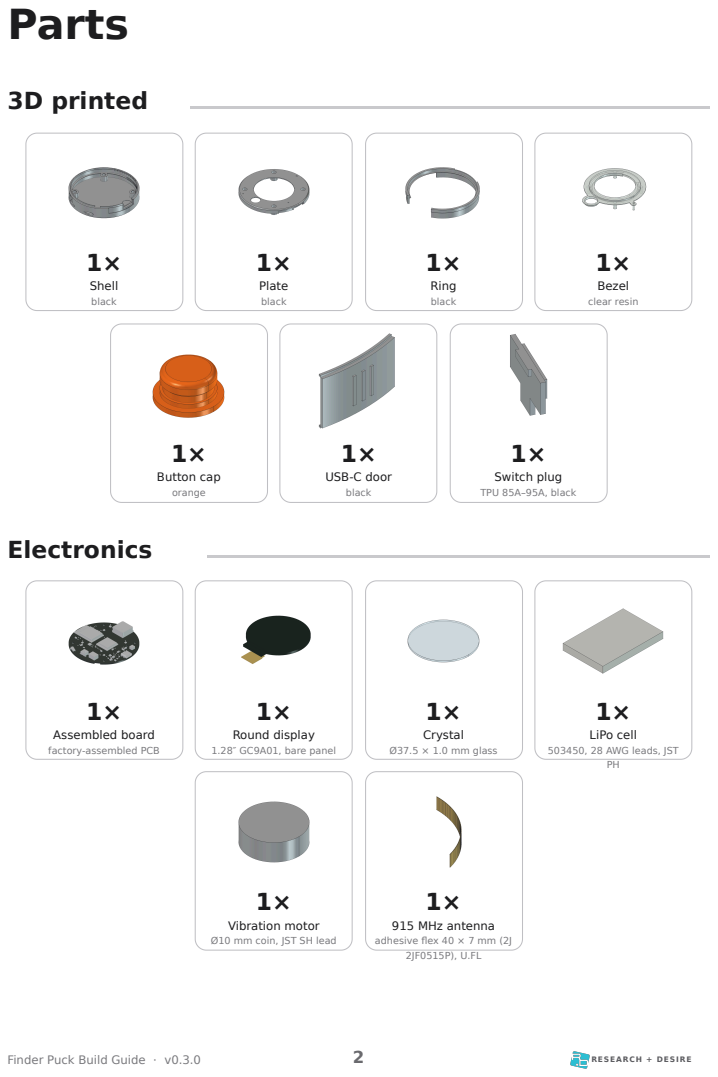
[picture p59: page 2]
Shell black; Plate black; Ring black; Bezel clear resin; Button cap orange; USB-C door black; Switch plug TPU 85A–95A, black; Electronics; Round display 1.28″ GC9A01, bare panel; Crystal Ø37.5 × 1.0 mm glass; LiPo cell; Finder Puck Build Guide · v0.3.0; RESEARCH + DESIRE

Assembled board
factory-assembled PCB

503450, 28 AWG leads, JST

Vibration motor
Ø10 mm coin, JST SH lead

915 MHz antenna
adhesive flex 40 × 7 mm (2J

# Parts (continued)

# Hardware

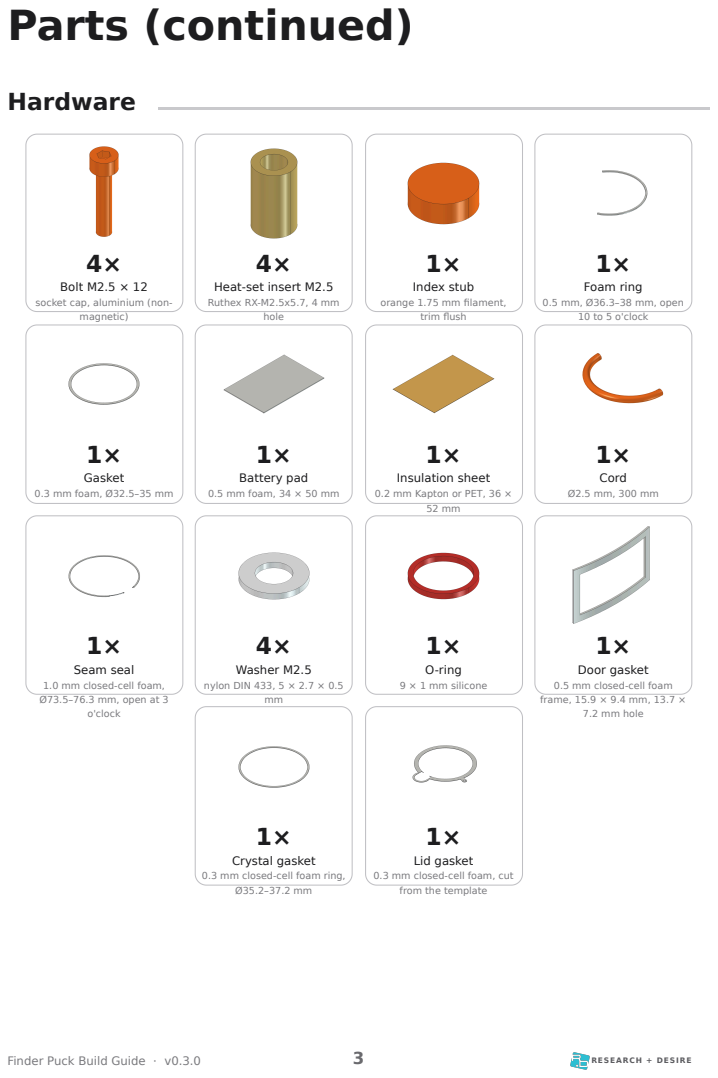
[picture p60: page 3]
magnetic); hole; trim flush; Foam ring; 10 to 5 o'clock; Gasket; Cord Ø2.5 mm, 300 mm; o'clock; Washer M2.5 nylon DIN 433, 5 × 2.7 × 0.5 mm; O-ring 9 × 1 mm silicone; 7.2 mm hole; Lid gasket; Finder Puck Build Guide · v0.3.0; RESEARCH + DESIRE

Bolt M2.5 × 12
socket cap, aluminium (non-

Heat-set insert M2.5
Ruthex RX-M2.5x5.7, 4 mm

Index stub
orange 1.75 mm filament,

0.5 mm, Ø36.3–38 mm, open

Battery pad
0.5 mm foam, 34 × 50 mm

Insulation sheet
0.2 mm Kapton or PET, 36 ×

0.3 mm foam, Ø32.5–35 mm

Seam seal
1.0 mm closed-cell foam,
Ø73.5–76.3 mm, open at 3

Door gasket
0.5 mm closed-cell foam
frame, 15.9 × 9.4 mm, 13.7 ×

Crystal gasket
0.3 mm closed-cell foam ring,

0.3 mm closed-cell foam, cut
from the template

# Tools

# Required

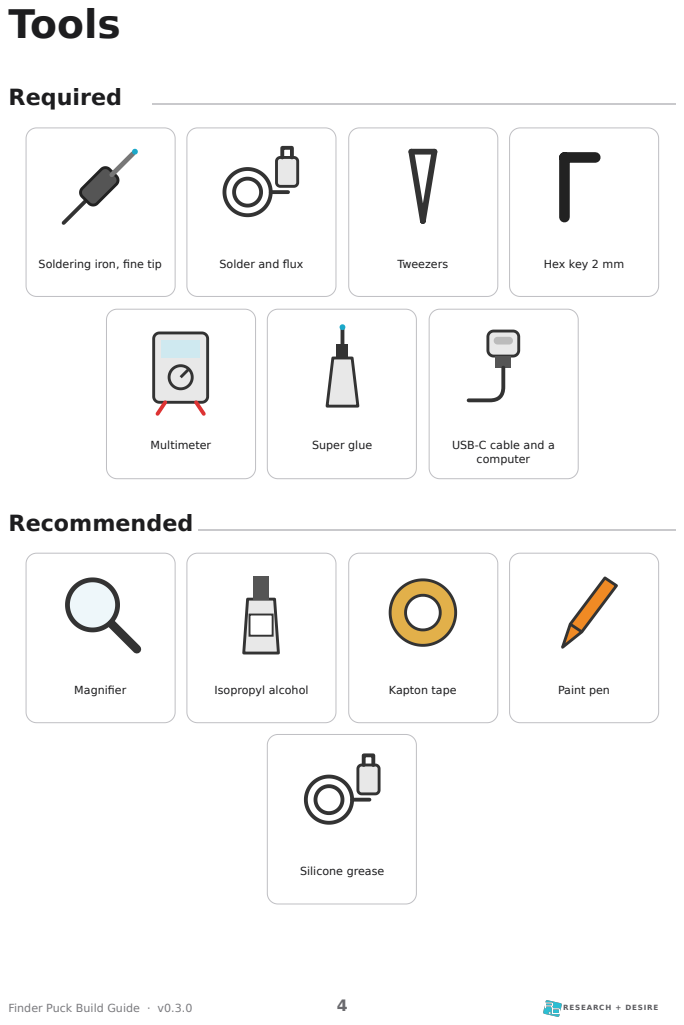
[picture p61: page 4]
Soldering iron, fine tip; Solder and flux; Tweezers; Hex key 2 mm; Multimeter; Super glue; USB-C cable and a; computer; Recommended; Magnifier; Isopropyl alcohol; Kapton tape; Paint pen; Silicone grease; Finder Puck Build Guide · v0.3.0; RESEARCH + DESIRE

# Before you start

Print | Shell upright, ring upside down (top face on the bed), plate face down, cap pocket down; 0.2 mm layers, four walls. Print the bezel in clear resin: its flange cannot be bridged and its fits are 0.25 mm. Print the door standing on its edge and the switch plug in TPU, standing on its strap end. Print a hole coupon before trusting the insert holes.
Sealing | The puck is built to IP55 (dust, water jets). That holds only with every seal in: the seam seal, a washer under each bolt head, the O-ring on the cap, the crystal and lid gaskets, the door slid shut and the switch plug pushed fully home. Cut the seam seal with a compass cutter; print case/finder_puck_gaskets.svg at 100 % and cut the lid, crystal and door gaskets along it.
Panel first | Buy two panels. Before anything else, look at the flex: after it folds under the glass, pin 1 must land on the 3 o'clock side of the board's pads. If yours is mirrored, the board needs regenerating with FPC_PIN1_RIGHT flipped, not a different fold.
Battery | The cell is live whatever the switch does. It is plugged in only after the soldering (step 9), and the insulation sheet goes on it before the board. Check the lead's polarity with the meter; many cells are wired the other way round.
Iron | 220 °C for the inserts, 320 °C with plenty of flux for the 0.7 mm flex. Clean with alcohol.
Compass | Keep steel away from the compass: aluminium bolts only, no steel screws or magnets near the puck.
Finder Puck Build Guide · v0.3.0 | 5 | RESEARCH + DESIRE

1

1×

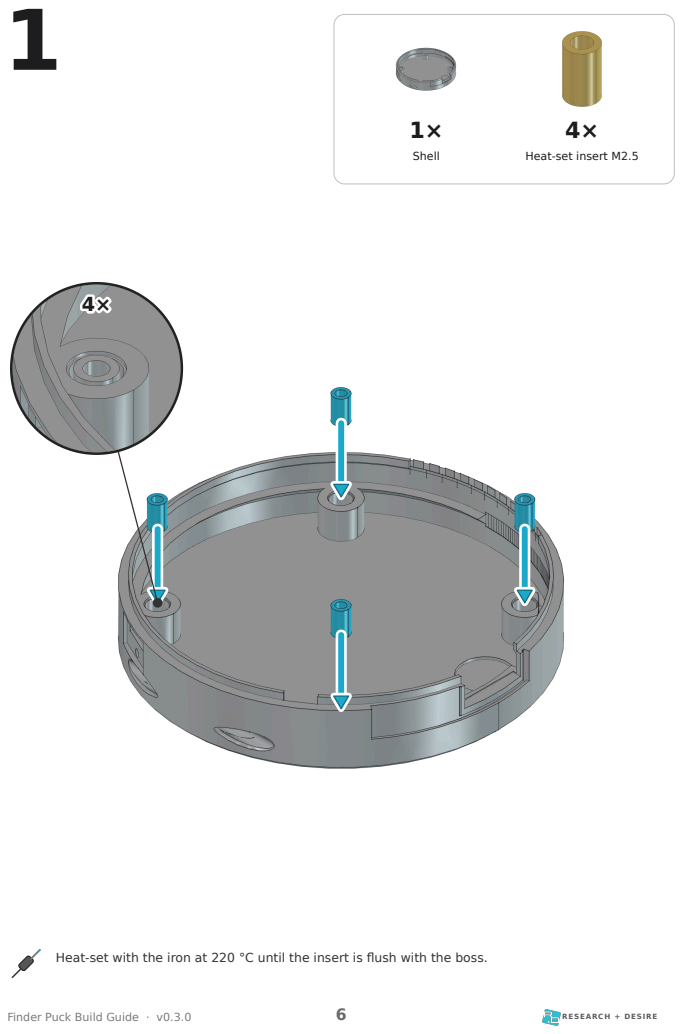
[picture p62: page 6]
Shell; Finder Puck Build Guide · v0.3.0; RESEARCH + DESIRE

Heat-set insert M2.5

Heat-set with the iron at 220 °C until the insert is flush with the boss.

2

1×

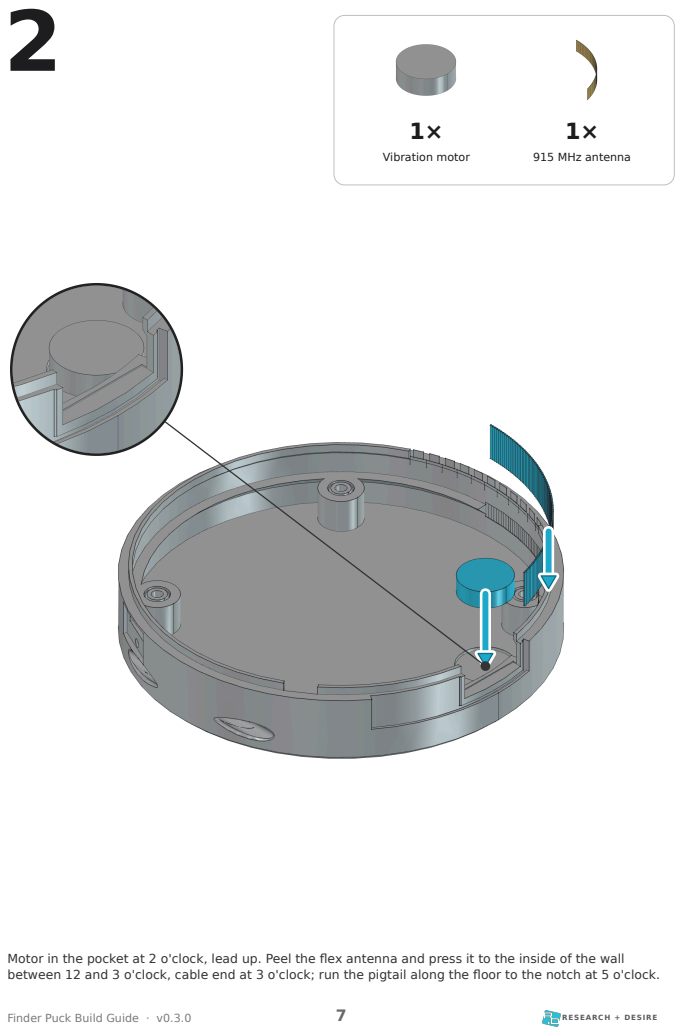
[picture p63: page 7]
Vibration motor; 915 MHz antenna; Finder Puck Build Guide · v0.3.0; RESEARCH + DESIRE

Motor in the pocket at 2 o'clock, lead up. Peel the flex antenna and press it to the inside of the wall
between 12 and 3 o'clock, cable end at 3 o'clock; run the pigtail along the floor to the notch at 5 o'clock.

3

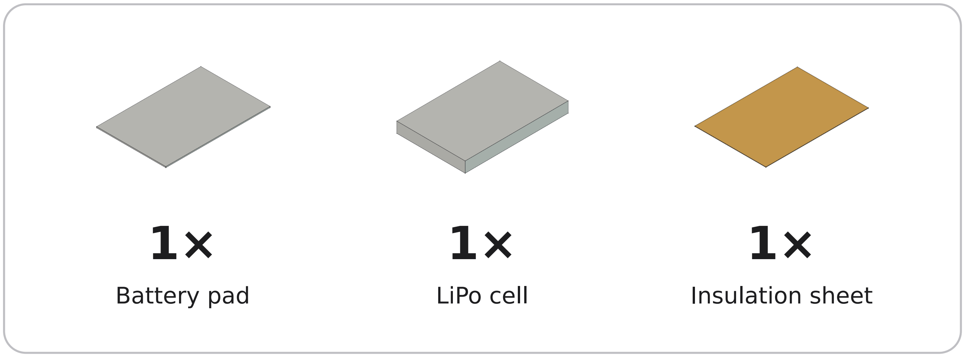
[picture p64: figure]
Battery pad; LiPo cell; Insulation sheet
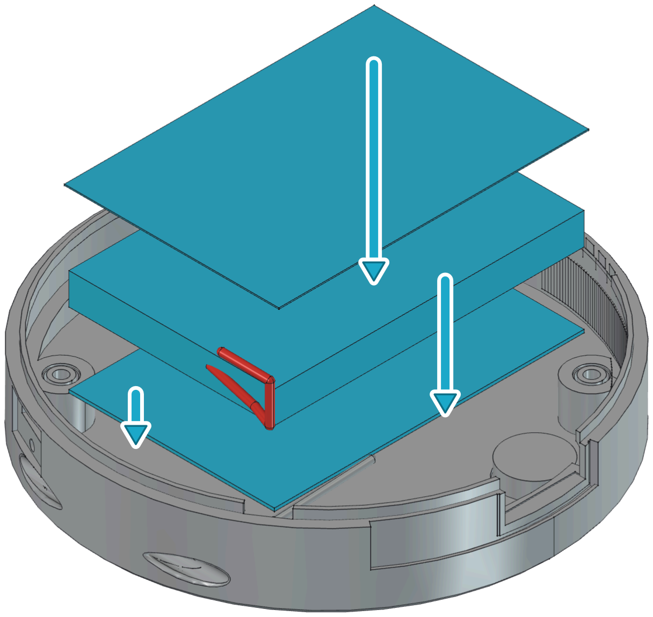
[picture p65: figure]

Pad first, the cell on it with its lead toward 5 o'clock, then the insulation sheet on top of the cell. Do not pinch the lead.

Finder Puck Build Guide · v0.3.0 | 8 | RESEARCH + DESIRE

4

1×

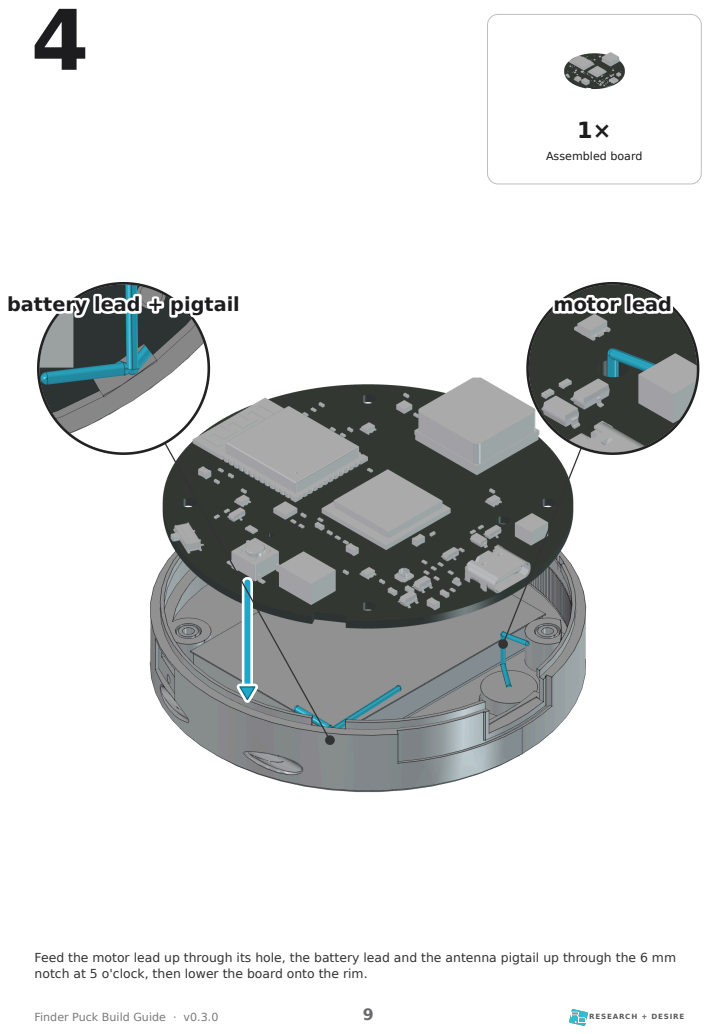
[picture p66: page 9]
Assembled board; bbaatttteerry y lleeaadd ++ ppiiggttaaiill; mmoottoorr lleeaadd; Finder Puck Build Guide · v0.3.0; RESEARCH + DESIRE

Feed the motor lead up through its hole, the battery lead and the antenna pigtail up through the 6 mm
notch at 5 o'clock, then lower the board onto the rim.

5

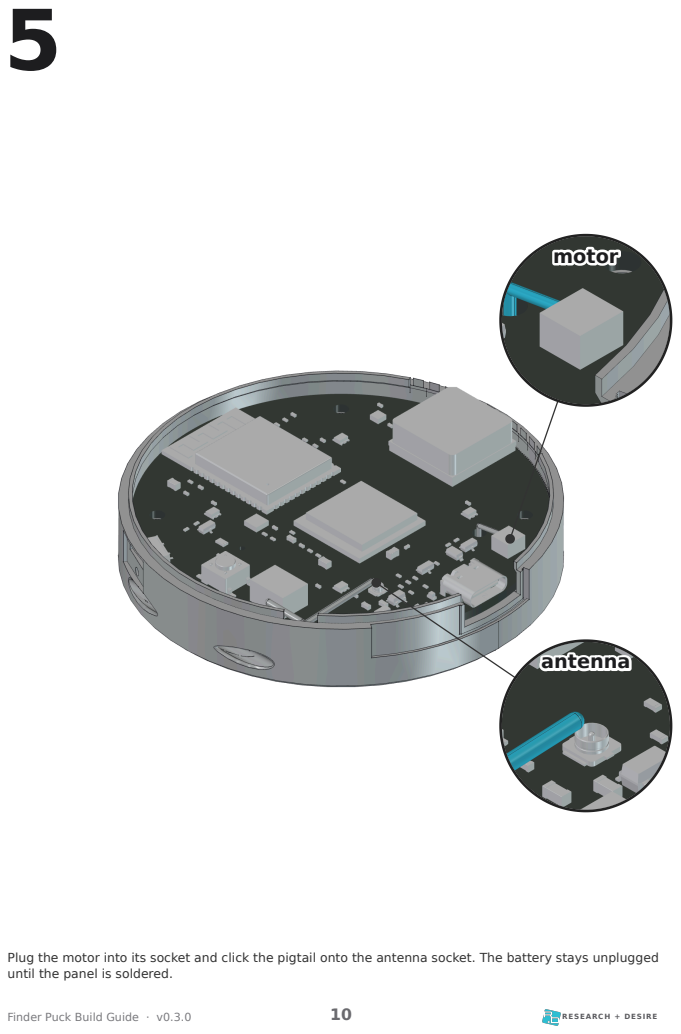
[picture p67: page 10]
motor; aanntteennnnaa; Finder Puck Build Guide · v0.3.0; RESEARCH + DESIRE

Plug the motor into its socket and click the pigtail onto the antenna socket. The battery stays unplugged
until the panel is soldered.

6

1×

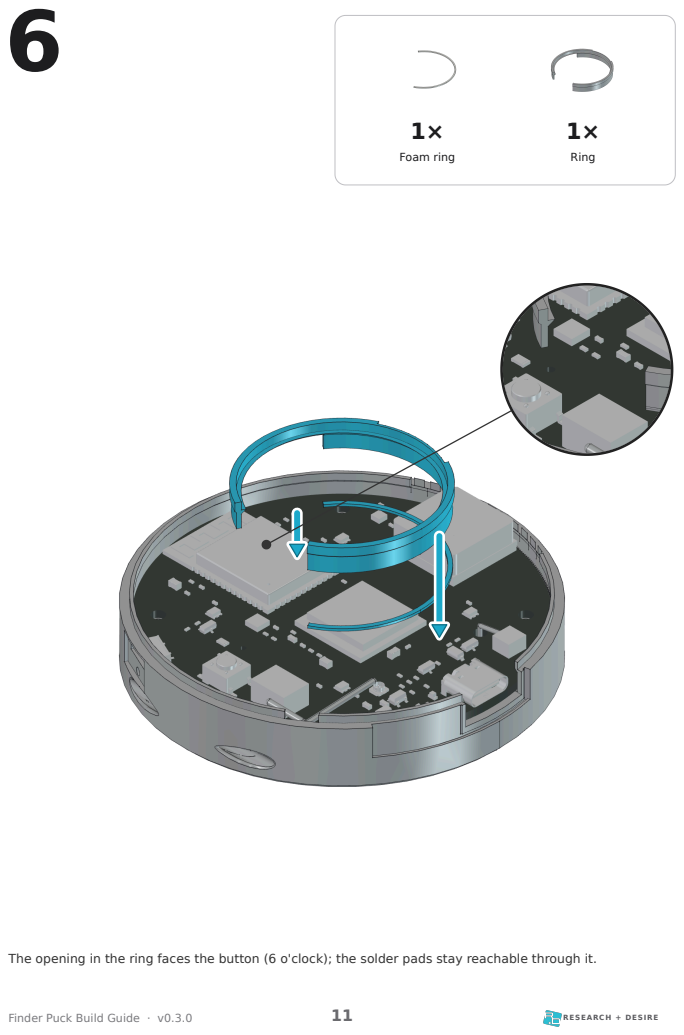
[picture p68: page 11]
Foam ring; Ring; Finder Puck Build Guide · v0.3.0; RESEARCH + DESIRE

The opening in the ring faces the button (6 o'clock); the solder pads stay reachable through it.

7

1×

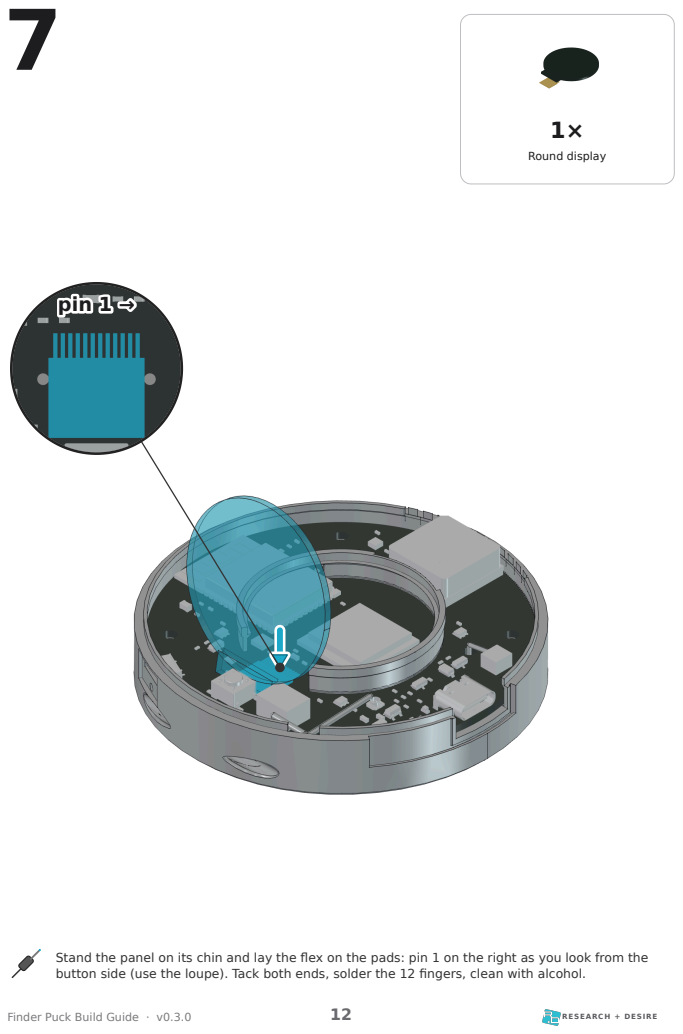
[picture p69: page 12]
Round display; ppiinn 11 →→; Finder Puck Build Guide · v0.3.0; RESEARCH + DESIRE

Stand the panel on its chin and lay the flex on the pads: pin 1 on the right as you look from the
button side (use the loupe). Tack both ends, solder the 12 fingers, clean with alcohol.

8

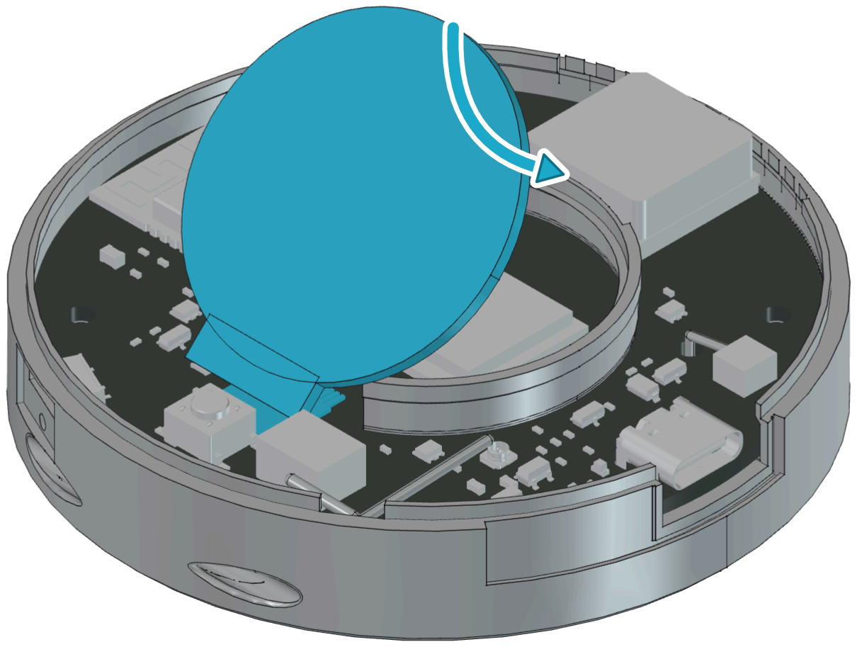
[picture p70: figure]

Fold the panel down onto the ledge. The flex bends once, under the glass; never crease it.

Finder Puck Build Guide · v0.3.0 | 13 | RESEARCH + DESIRE

9

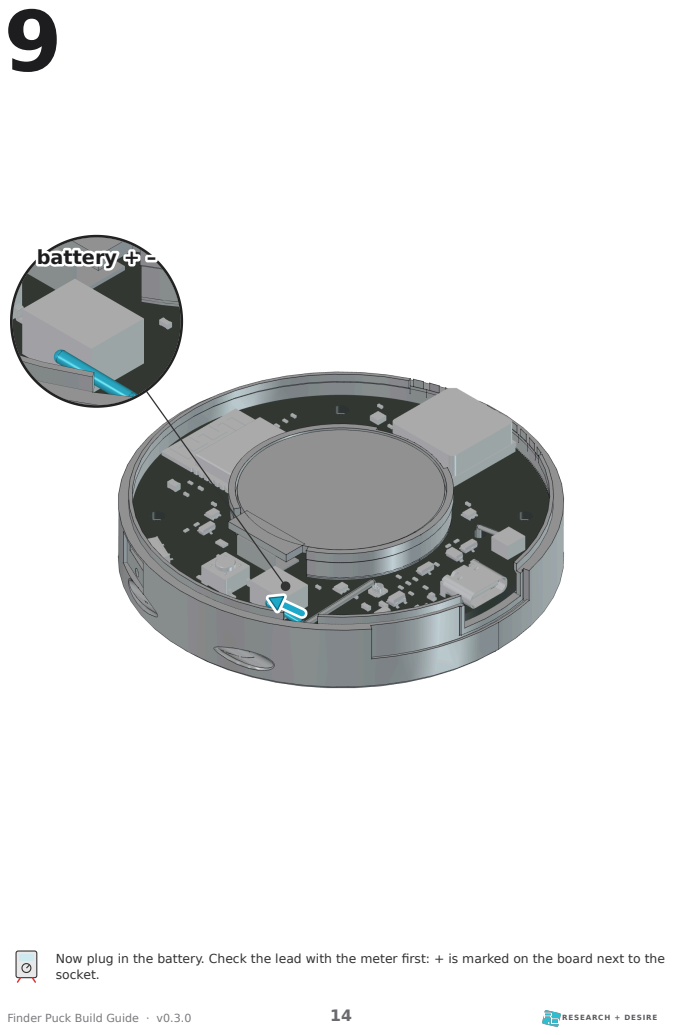
[picture p71: page 14]
bbaatttteerry y ++ ––; Finder Puck Build Guide · v0.3.0; RESEARCH + DESIRE

Now plug in the battery. Check the lead with the meter first: + is marked on the board next to the
socket.

10

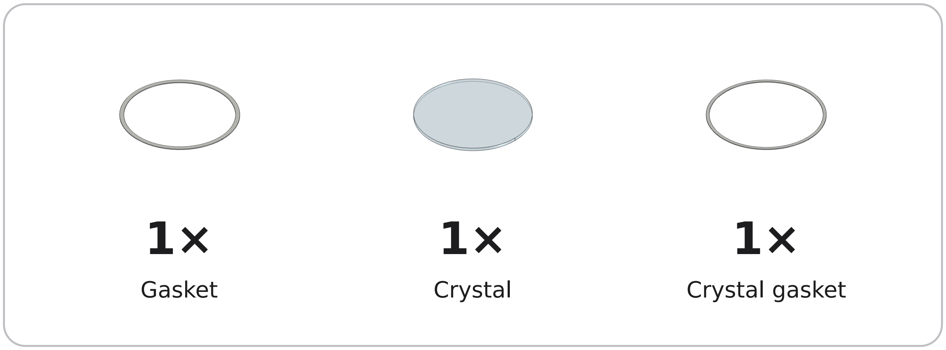
[picture p72: figure]
Gasket; Crystal; Crystal gasket
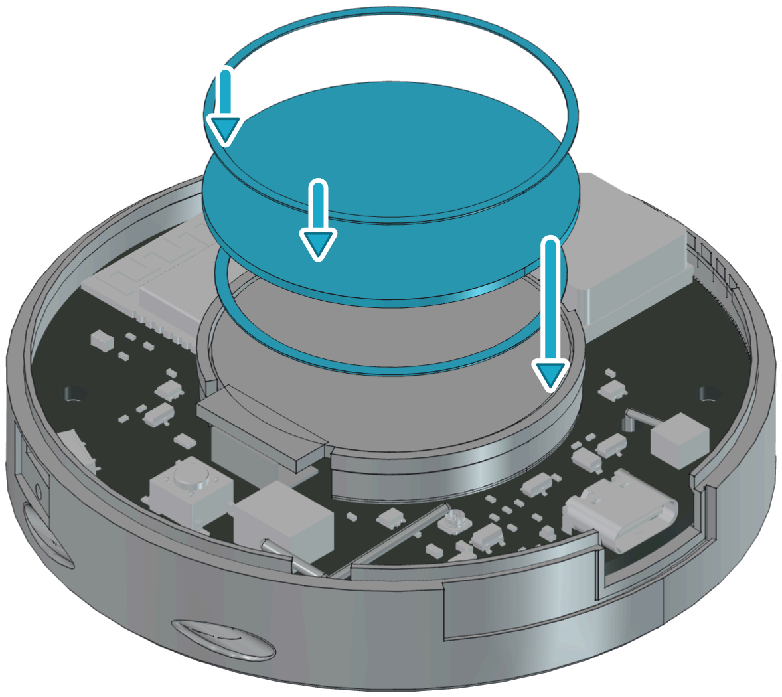
[picture p73: figure]

Blow the dust off the glass first. The crystal rests on the ring, not on the panel. Lay the crystal gasket on the glass's edge, centred, adhesive side up: it sticks to the bezel's lip and comes off with the lid.

Finder Puck Build Guide · v0.3.0 | 15 | RESEARCH + DESIRE

11

1×

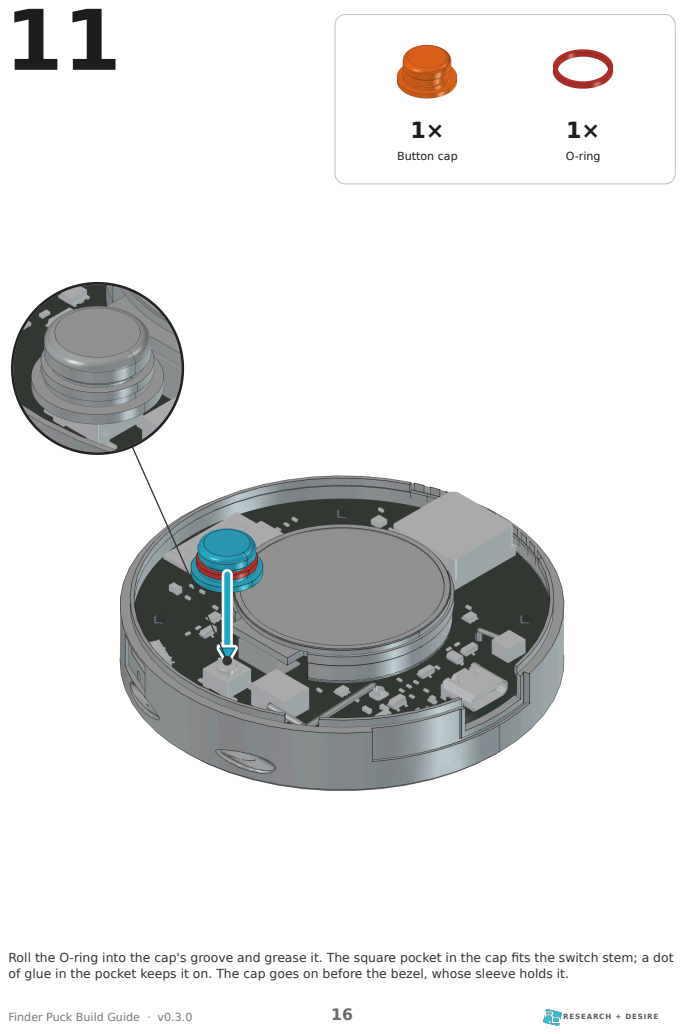
[picture p74: page 16]
Button cap; O-ring; Finder Puck Build Guide · v0.3.0; RESEARCH + DESIRE

Roll the O-ring into the cap's groove and grease it. The square pocket in the cap fits the switch stem; a dot
of glue in the pocket keeps it on. The cap goes on before the bezel, whose sleeve holds it.

12

1×

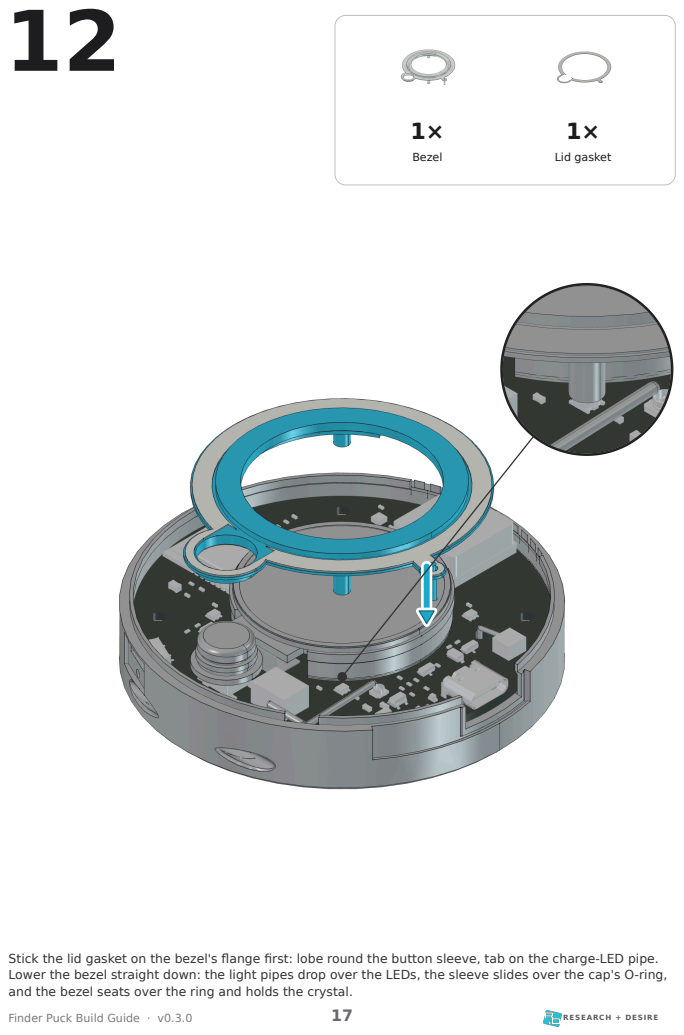
[picture p75: page 17]
Bezel; Lid gasket; Finder Puck Build Guide · v0.3.0; RESEARCH + DESIRE

Stick the lid gasket on the bezel's flange first: lobe round the button sleeve, tab on the charge-LED pipe.
Lower the bezel straight down: the light pipes drop over the LEDs, the sleeve slides over the cap's O-ring,
and the bezel seats over the ring and holds the crystal.

13

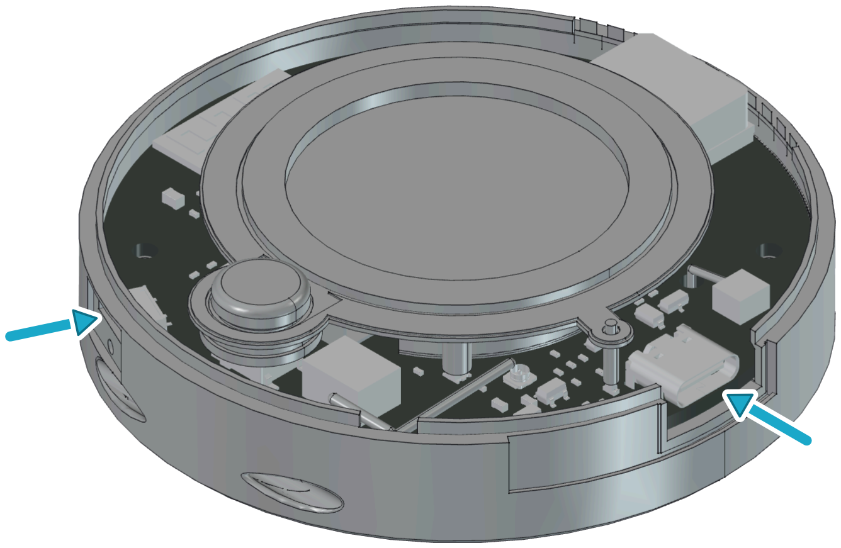
[picture p76: figure]

Test before the plate goes on: plug in USB-C, flash the firmware, slide the switch toward the dot. The screen lights, the four LEDs strobe when you press the button, the motor ticks. Switch off again.
Finder Puck Build Guide · v0.3.0 | 18 | RESEARCH + DESIRE

14

1×

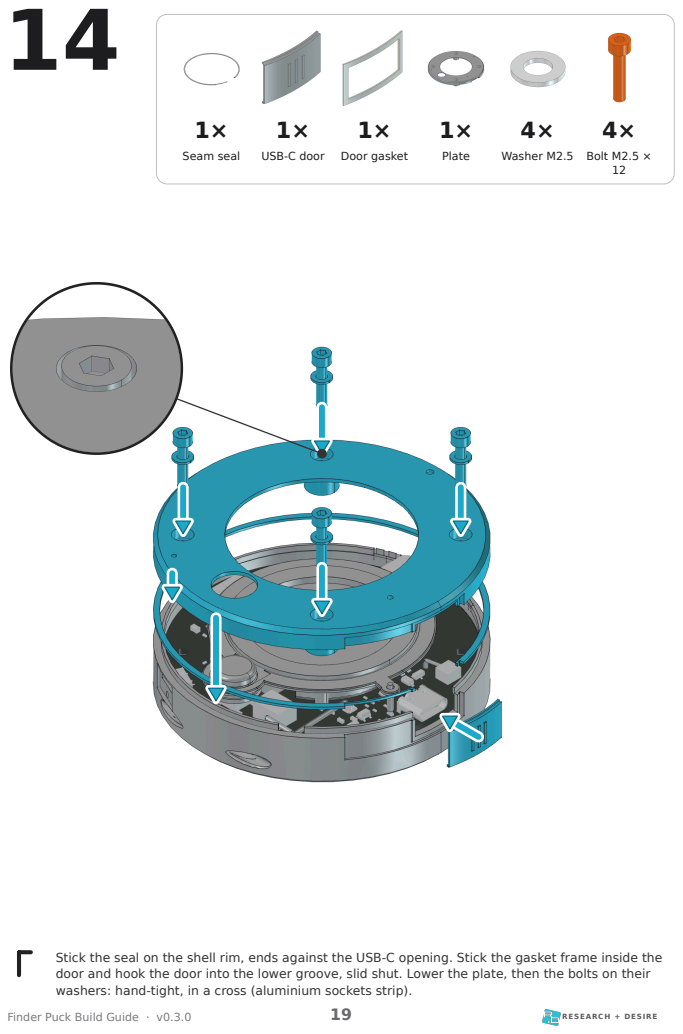
[picture p77: page 19]
Seam seal; USB-C door; Door gasket; Plate; Washer M2.5; Bolt M2.5 × 12; Finder Puck Build Guide · v0.3.0; RESEARCH + DESIRE

Stick the seal on the shell rim, ends against the USB-C opening. Stick the gasket frame inside the
door and hook the door into the lower groove, slid shut. Lower the plate, then the bolts on their
washers: hand-tight, in a cross (aluminium sockets strip).

15

1×

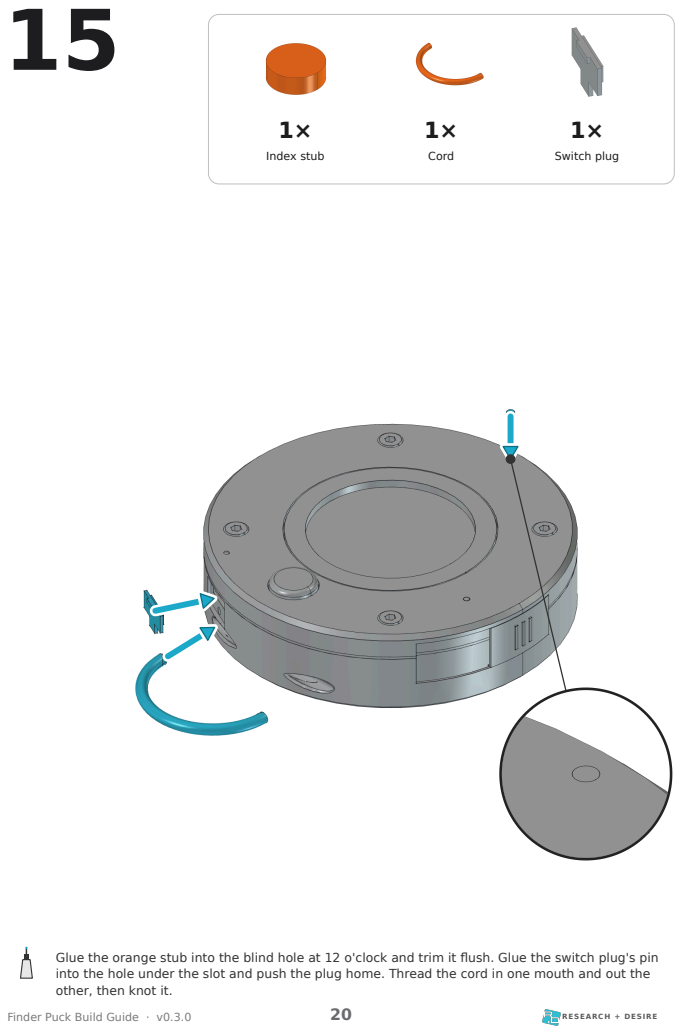
[picture p78: page 20]
Index stub; Cord; Switch plug; Finder Puck Build Guide · v0.3.0; RESEARCH + DESIRE

Glue the orange stub into the blind hole at 12 o'clock and trim it flush. Glue the switch plug's pin
into the hole under the slot and push the plug home. Thread the cord in one mouth and out the
other, then knot it.

16

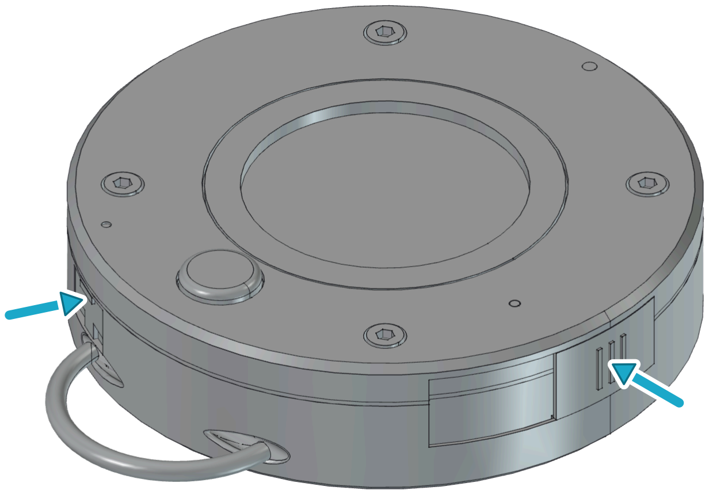
[picture p79: figure]

Lift the switch plug and slide the switch toward the dot to switch on. Charge with the puck off and dry; the light just below 3 o'clock goes out when full. Shut the door and push the switch plug home before it gets wet. Mark it 1 or 2 on the back.
Finder Puck Build Guide · v0.3.0 | 21 | RESEARCH + DESIRE

# Done

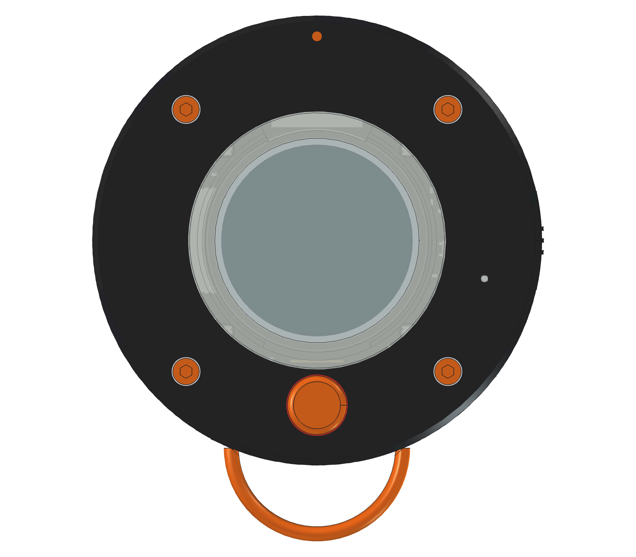
[picture p80: figure]

The orange dot is 12 o'clock. The arrow points at your partner and the blip sits at their range on the rings; the scale (50 m, 500 m, 5 km) is printed at 3 o'clock. While you hold the button the screen tells you what letting go will do.

# The button

Press | Beacon on or off for 60 s: both pucks strobe so your friend can spot you.
Double press | Vibration on or off (remembered).
Hold 2 s, release | Pairing mode. Hold again to cancel.
Hold 5 s, release | Compass calibration: turn the puck through a slow figure of eight.
Finder Puck Build Guide · v0.3.0 | 22 | RESEARCH + DESIRE

# RESEARCH + DESIRE

# Finder Puck Build Guide

## Round-screen puck, through-bolted · Version 0.3.0

Support

### support@researchanddesire.com

Design files
README.md in the finder-puck repository

Open hardware. The design files (KiCad board, FreeCAD case, this guide) are generated from scripts; see the README before changing anything by hand.

Finder Puck Build Guide · v0.3.0 | 23 | RESEARCH + DESIRE
