lucy-chapar/finder-puck/manual/img/card_swplug.png

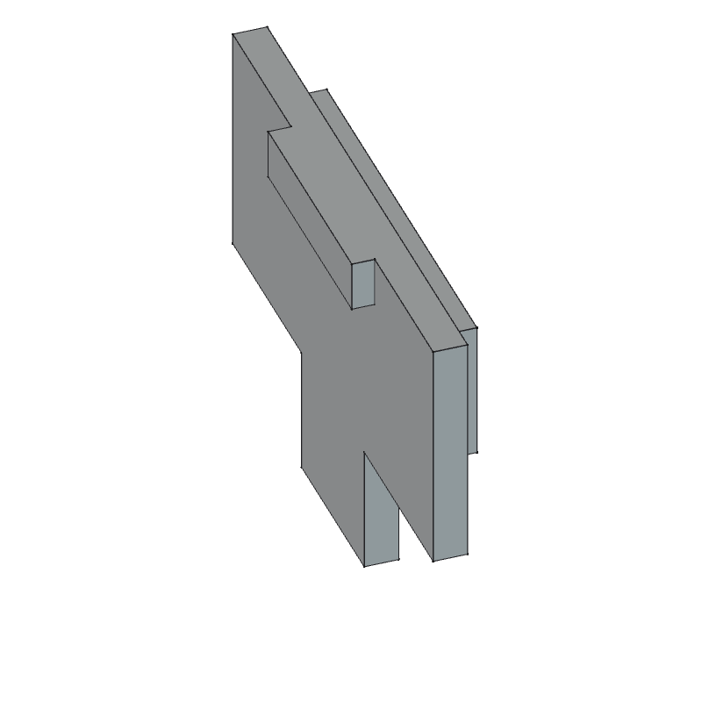
manual/img/card_swplug.png
