lucy-chapar/finder-puck/manual/img/s01_mag.png

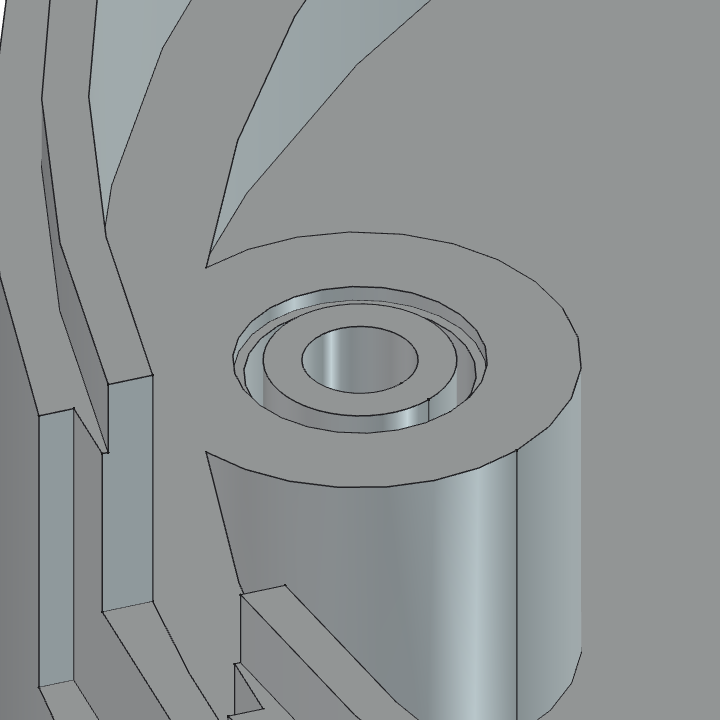
manual/img/s01_mag.png
