lucy-chapar/finder-puck/manual/img/s02_mag.png

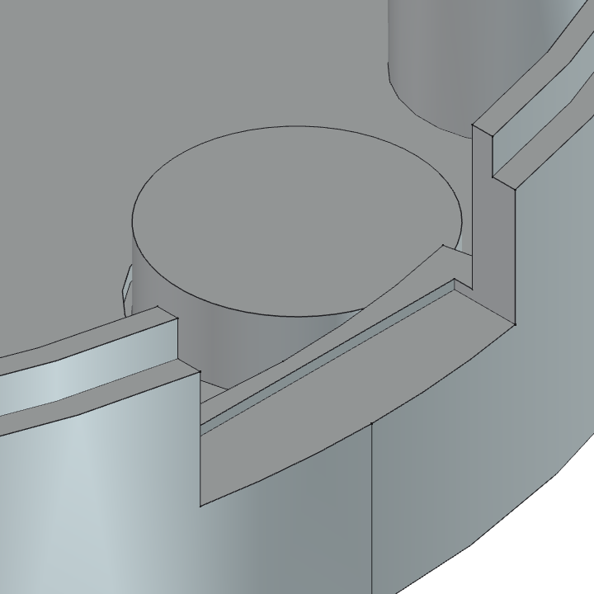
manual/img/s02_mag.png
