lucy-chapar/finder-puck/manual/img/s04_mag_h5.png

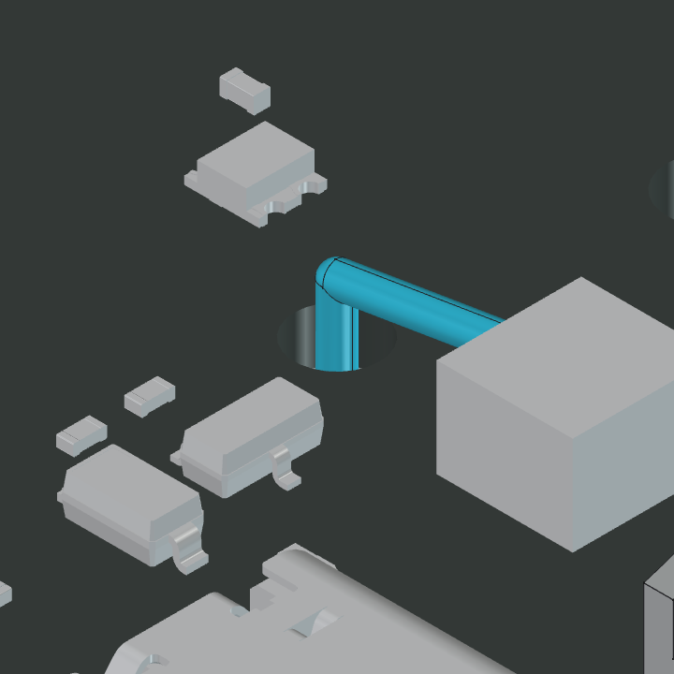
manual/img/s04_mag_h5.png
