lucy-chapar/finder-puck/manual/img/s04_mag_h6.png

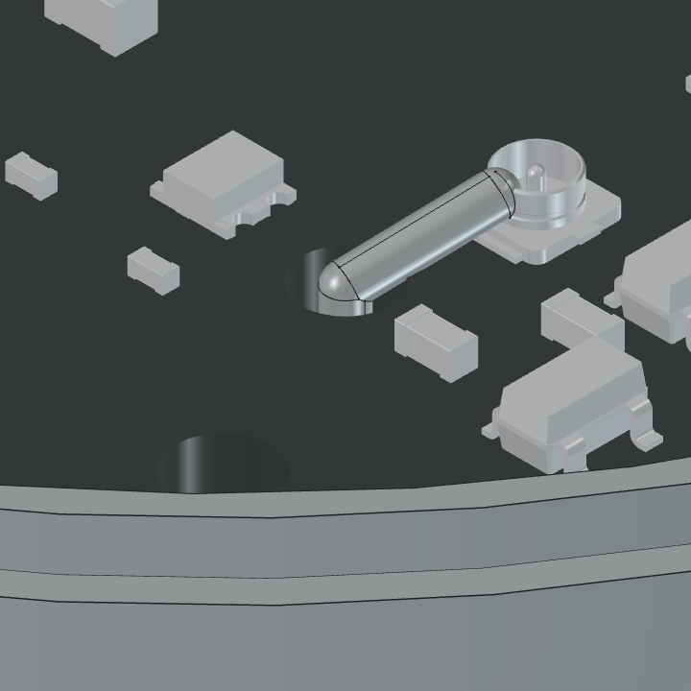
manual/img/s04_mag_h6.png
