lucy-chapar/finder-puck/manual/img/s04_mag_notch.png

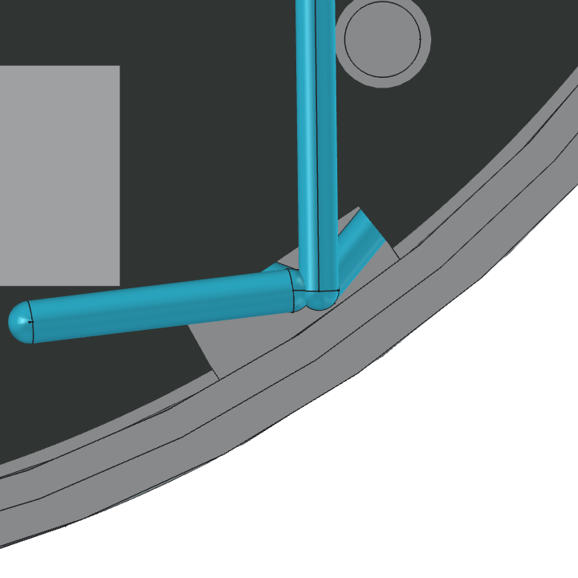
manual/img/s04_mag_notch.png
