lucy-chapar/finder-puck/manual/img/s05_mag_j2.png

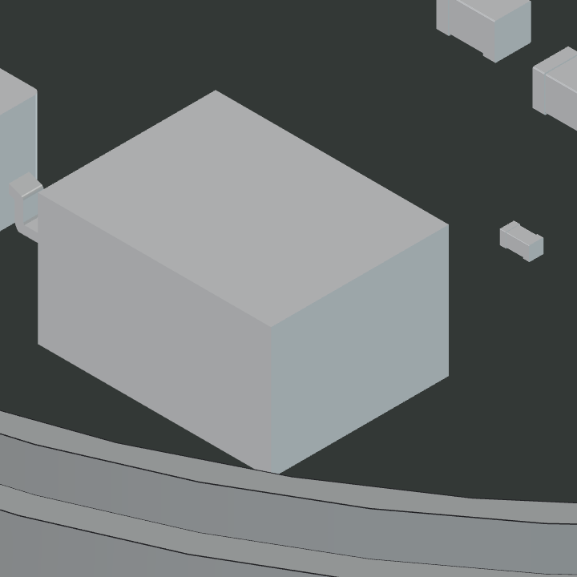
manual/img/s05_mag_j2.png
