lucy-chapar/finder-puck/manual/img/s05_mag_j4.png

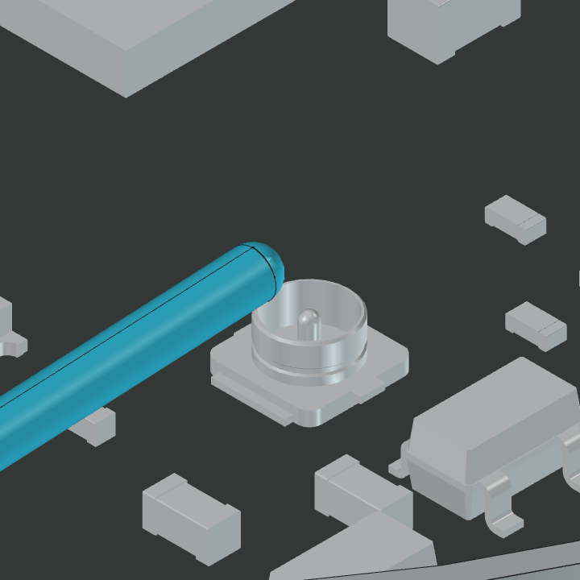
manual/img/s05_mag_j4.png
