lucy-chapar/finder-puck/manual/img/s05_mag_j5.png

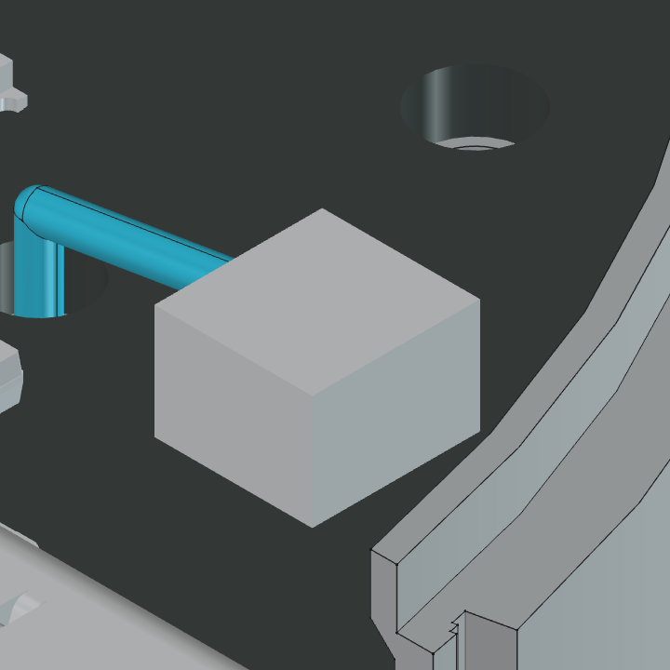
manual/img/s05_mag_j5.png
