lucy-chapar/finder-puck/manual/img/s06_mag.png

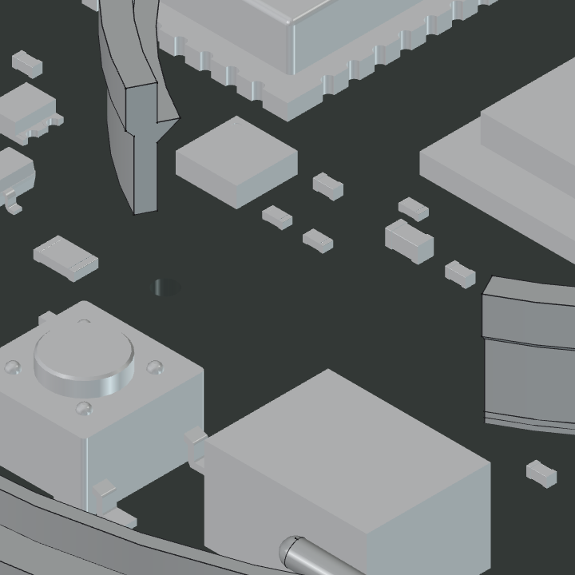
manual/img/s06_mag.png
