lucy-chapar/finder-puck/manual/img/s07_mag.png

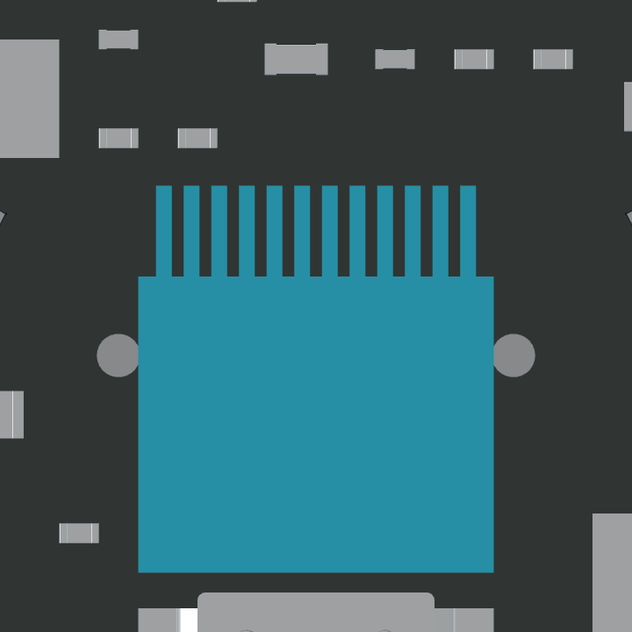
manual/img/s07_mag.png
