lucy-chapar/finder-puck/manual/img/s09_mag_j2.png

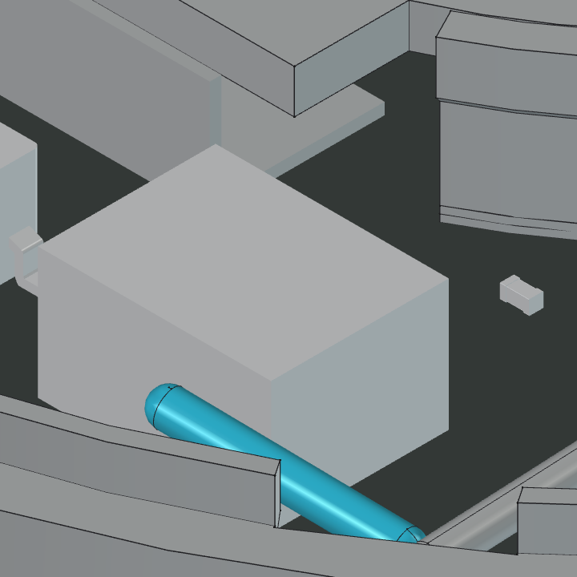
manual/img/s09_mag_j2.png
