lucy-chapar/finder-puck/manual/img/s10_mag.png

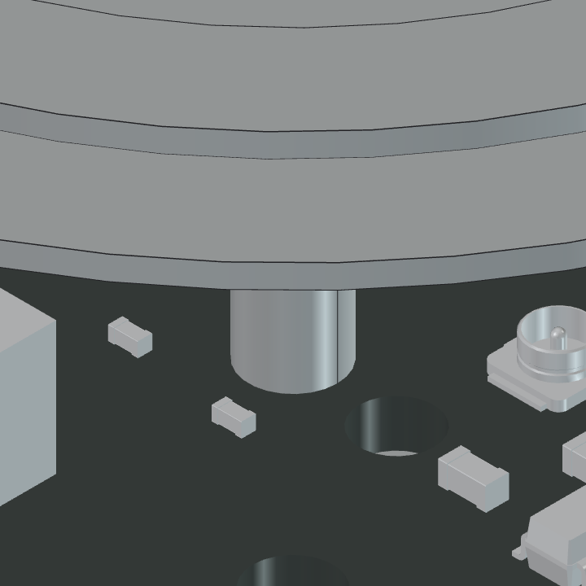
manual/img/s10_mag.png
