lucy-chapar/finder-puck/manual/img/s11_mag.png

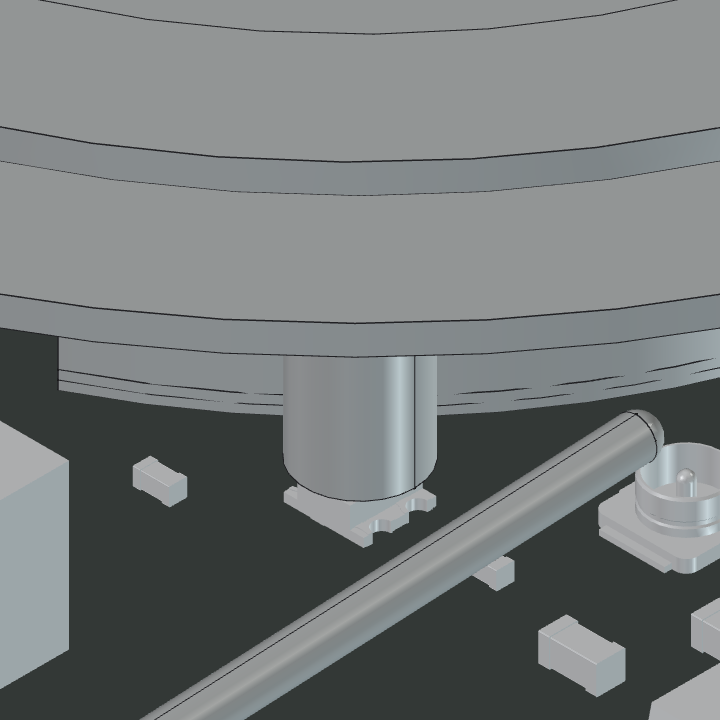
manual/img/s11_mag.png
