lucy-chapar/finder-puck/manual/img/s12_mag.png

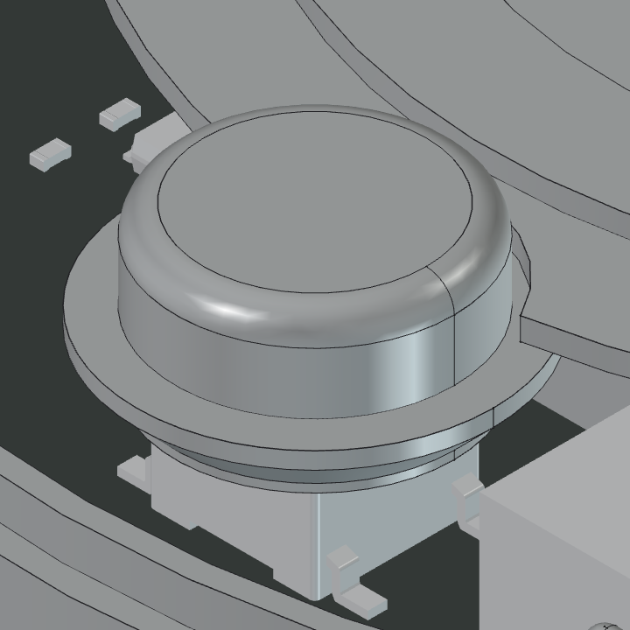
manual/img/s12_mag.png
