lucy-chapar/finder-puck/manual/img/s13_mag.png

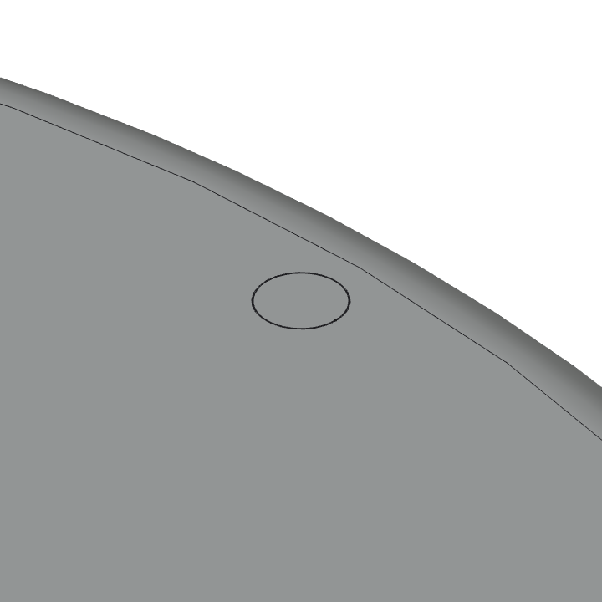
manual/img/s13_mag.png
