lucy-chapar/finder-puck/manual/img/s14_mag.png

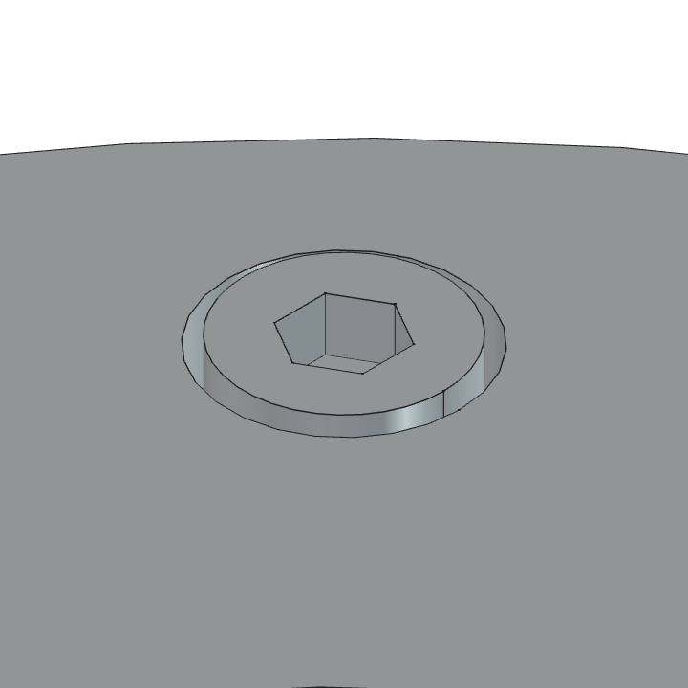
manual/img/s14_mag.png
