lucy-chapar/finder-puck/docs/schematic.pdf

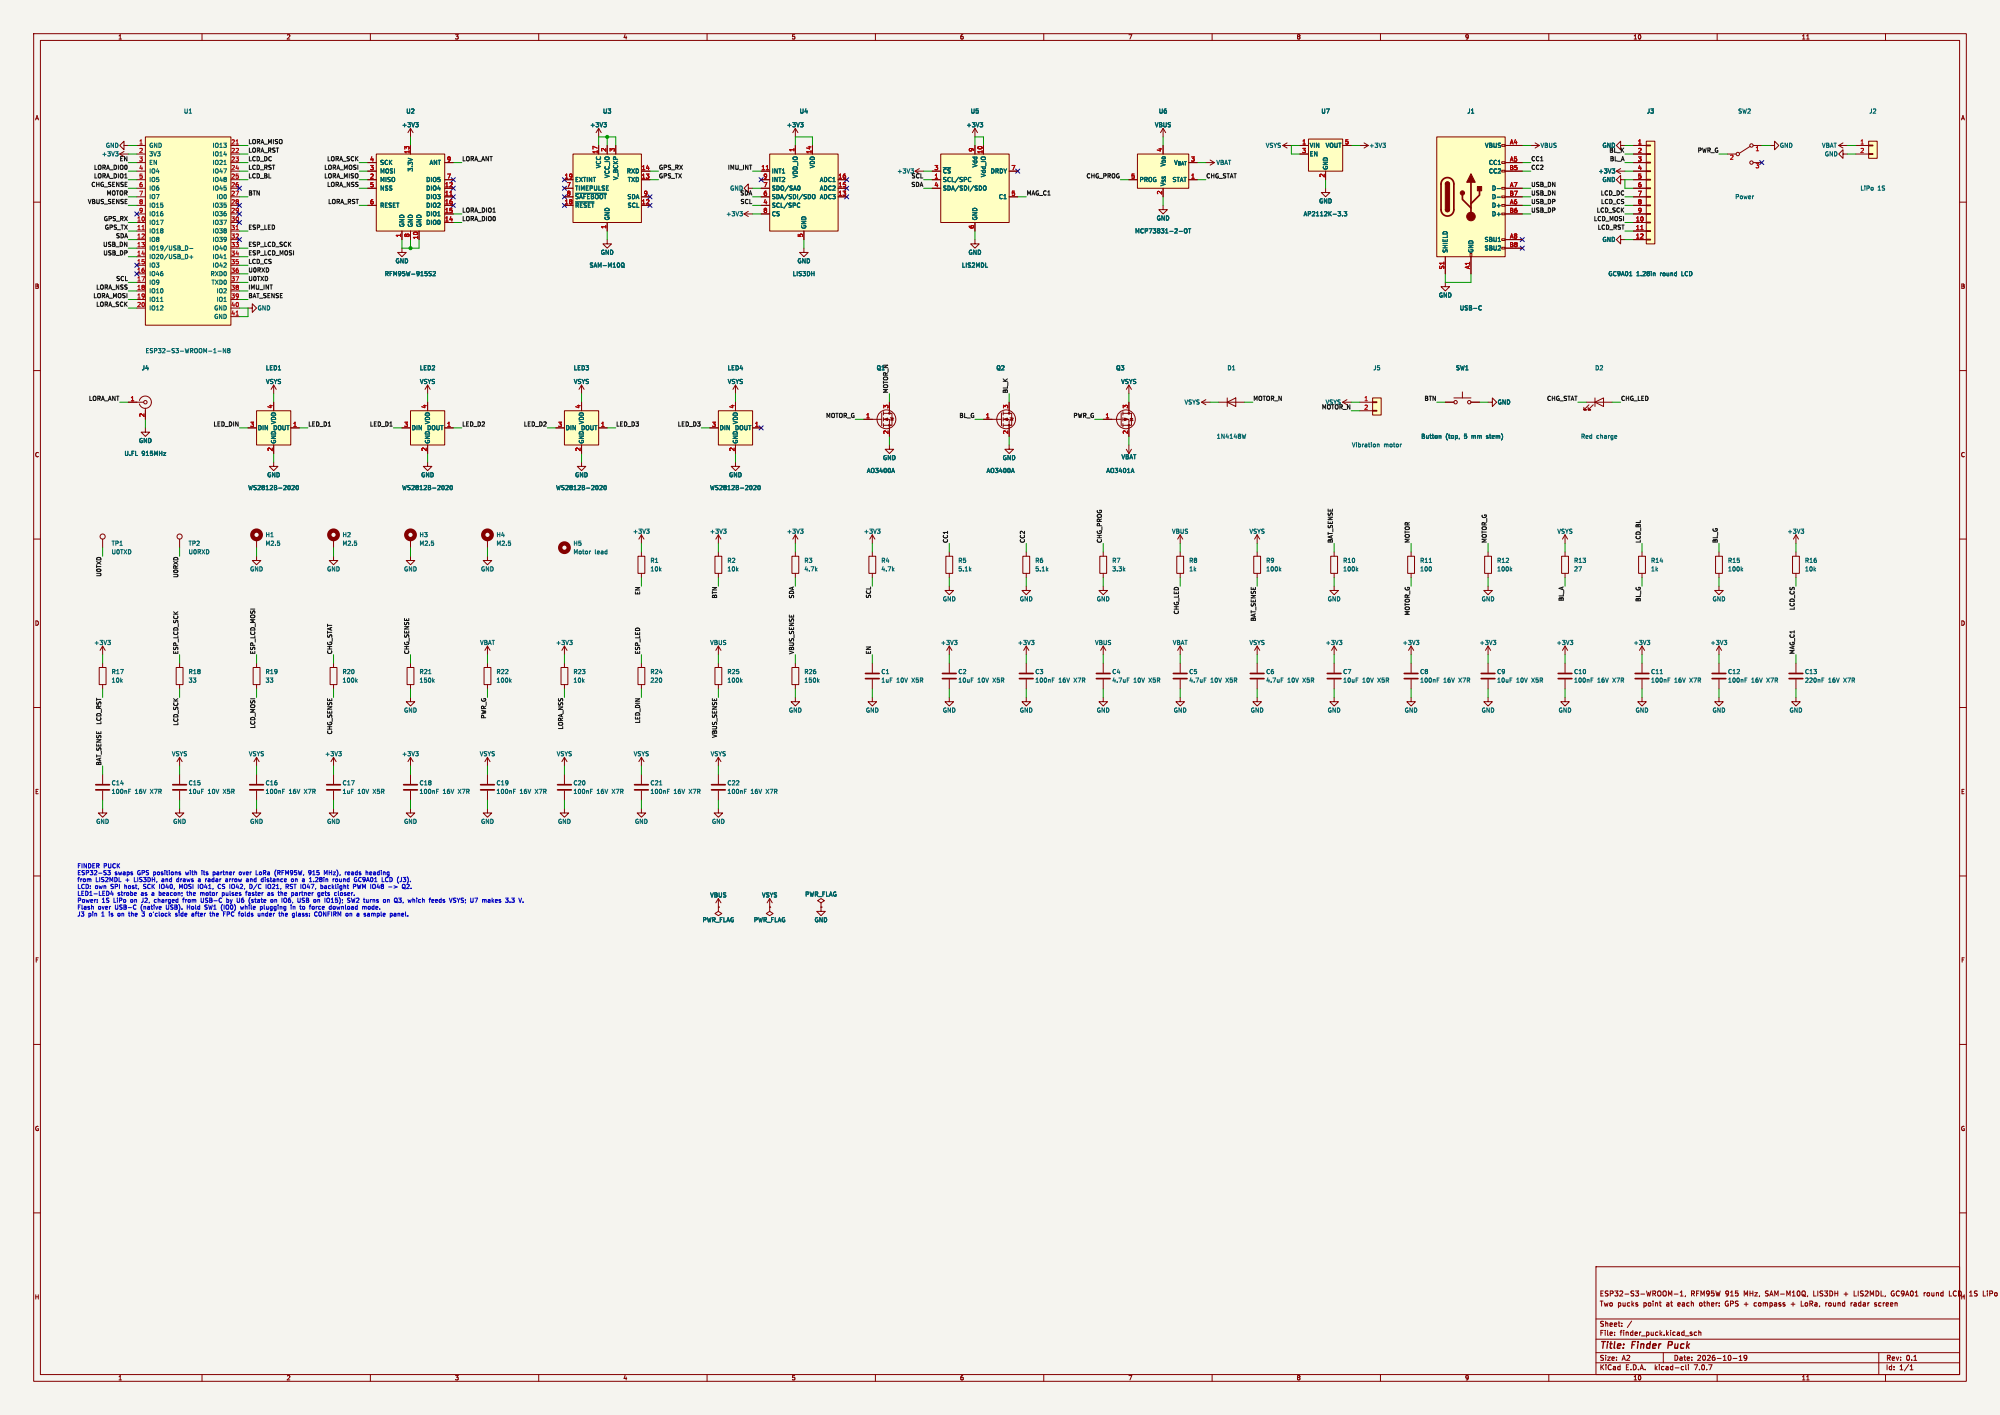
[picture p98: page 1]

3 TIMEPULSE 7 ~{SAFEBOOT} 8 SDA 9 U3 SAM-M10Q
+3V3 GND

1 GND 10 DIO3 11 DIO4 12 3.3V 13 DIO0 14 DIO1 15 DIO2 16 MISO 2 MOSI 3 SCK 4 NSS 5 RESET 6 DIO5 7 GND

1 SCL 12 TXD 13 RXD VCC 14 17

5 SDA/SDI/SDO 6 SDO/SA0 7 CS 8

SW1 Button (top, 5 mm stem)
