lucy-chapar/finder-puck/finder_puck.kicad_pcb

## KiCad design finder_puck.kicad_pcb (2026-10-23)

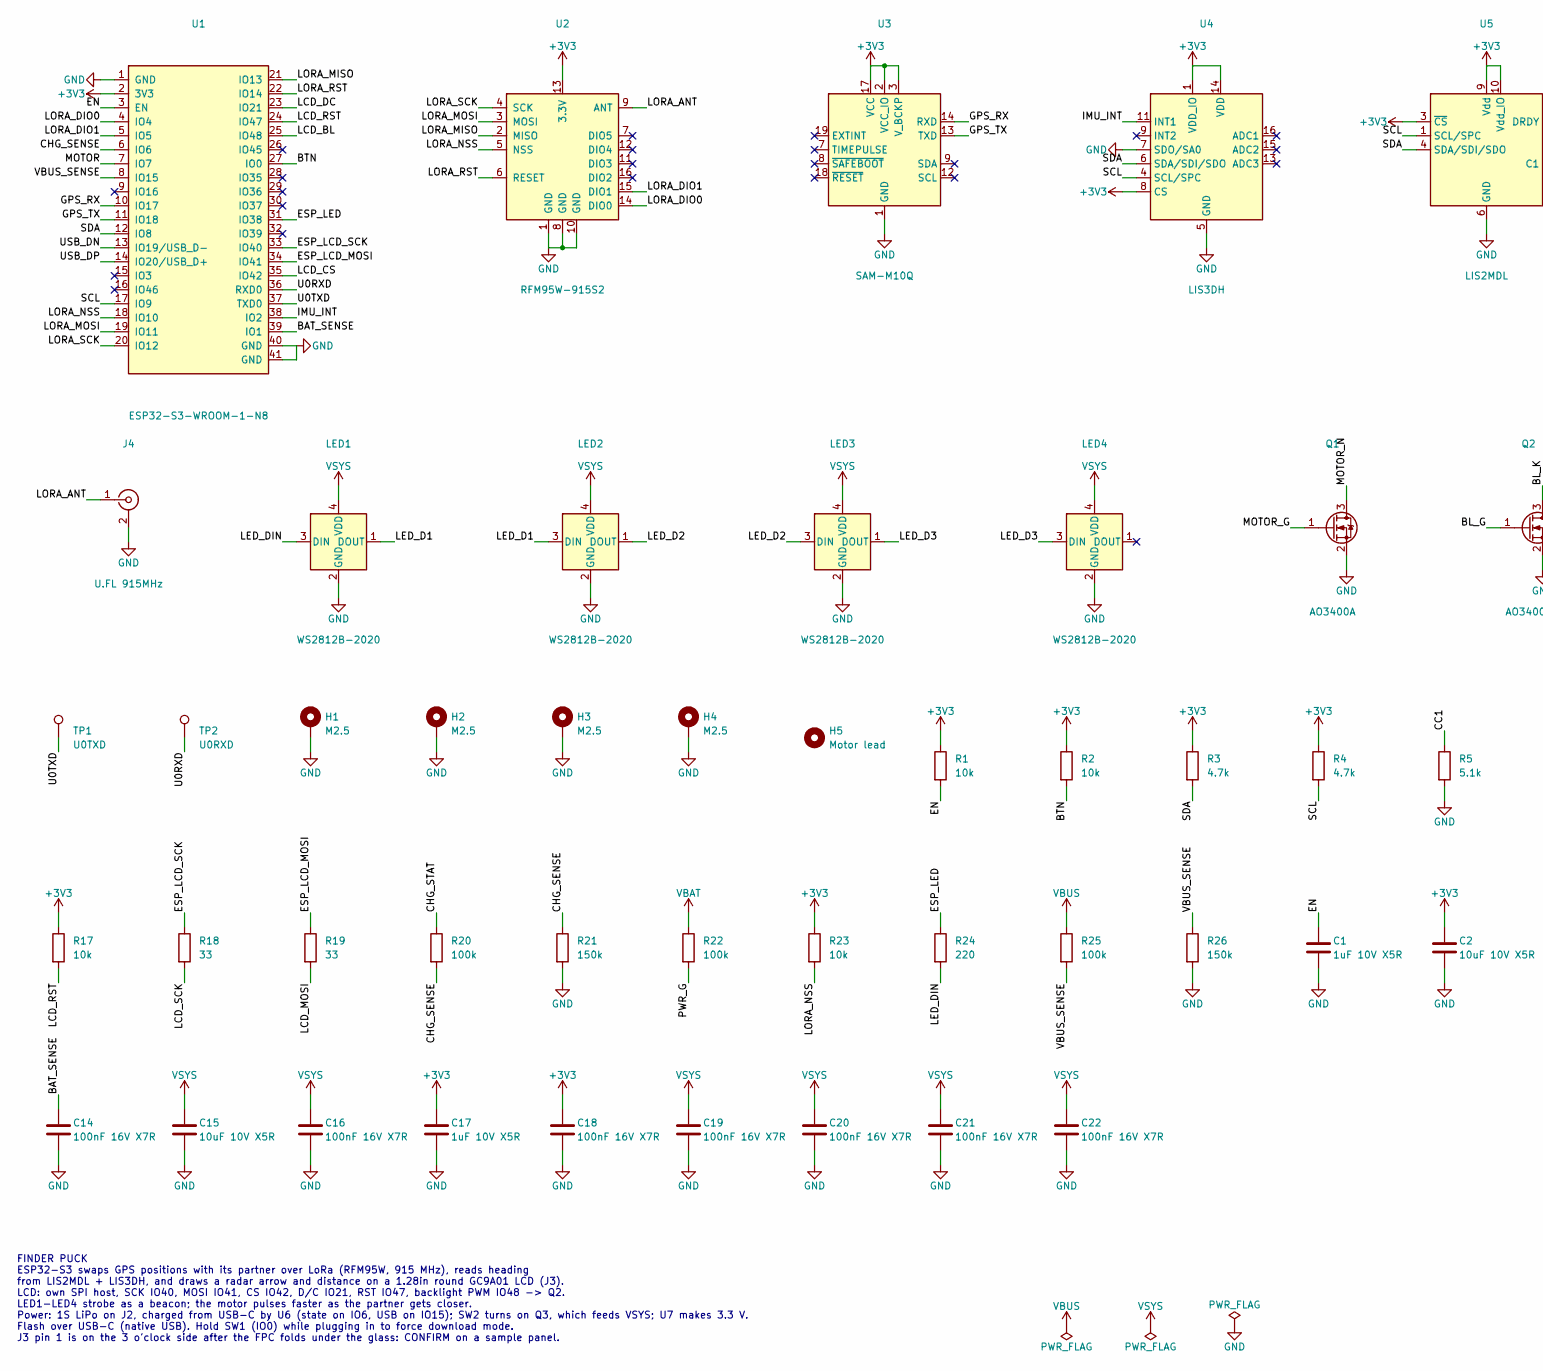
[picture p99: schematic finder_puck.kicad_sch, Finder Puck, part in row 1, column 1]

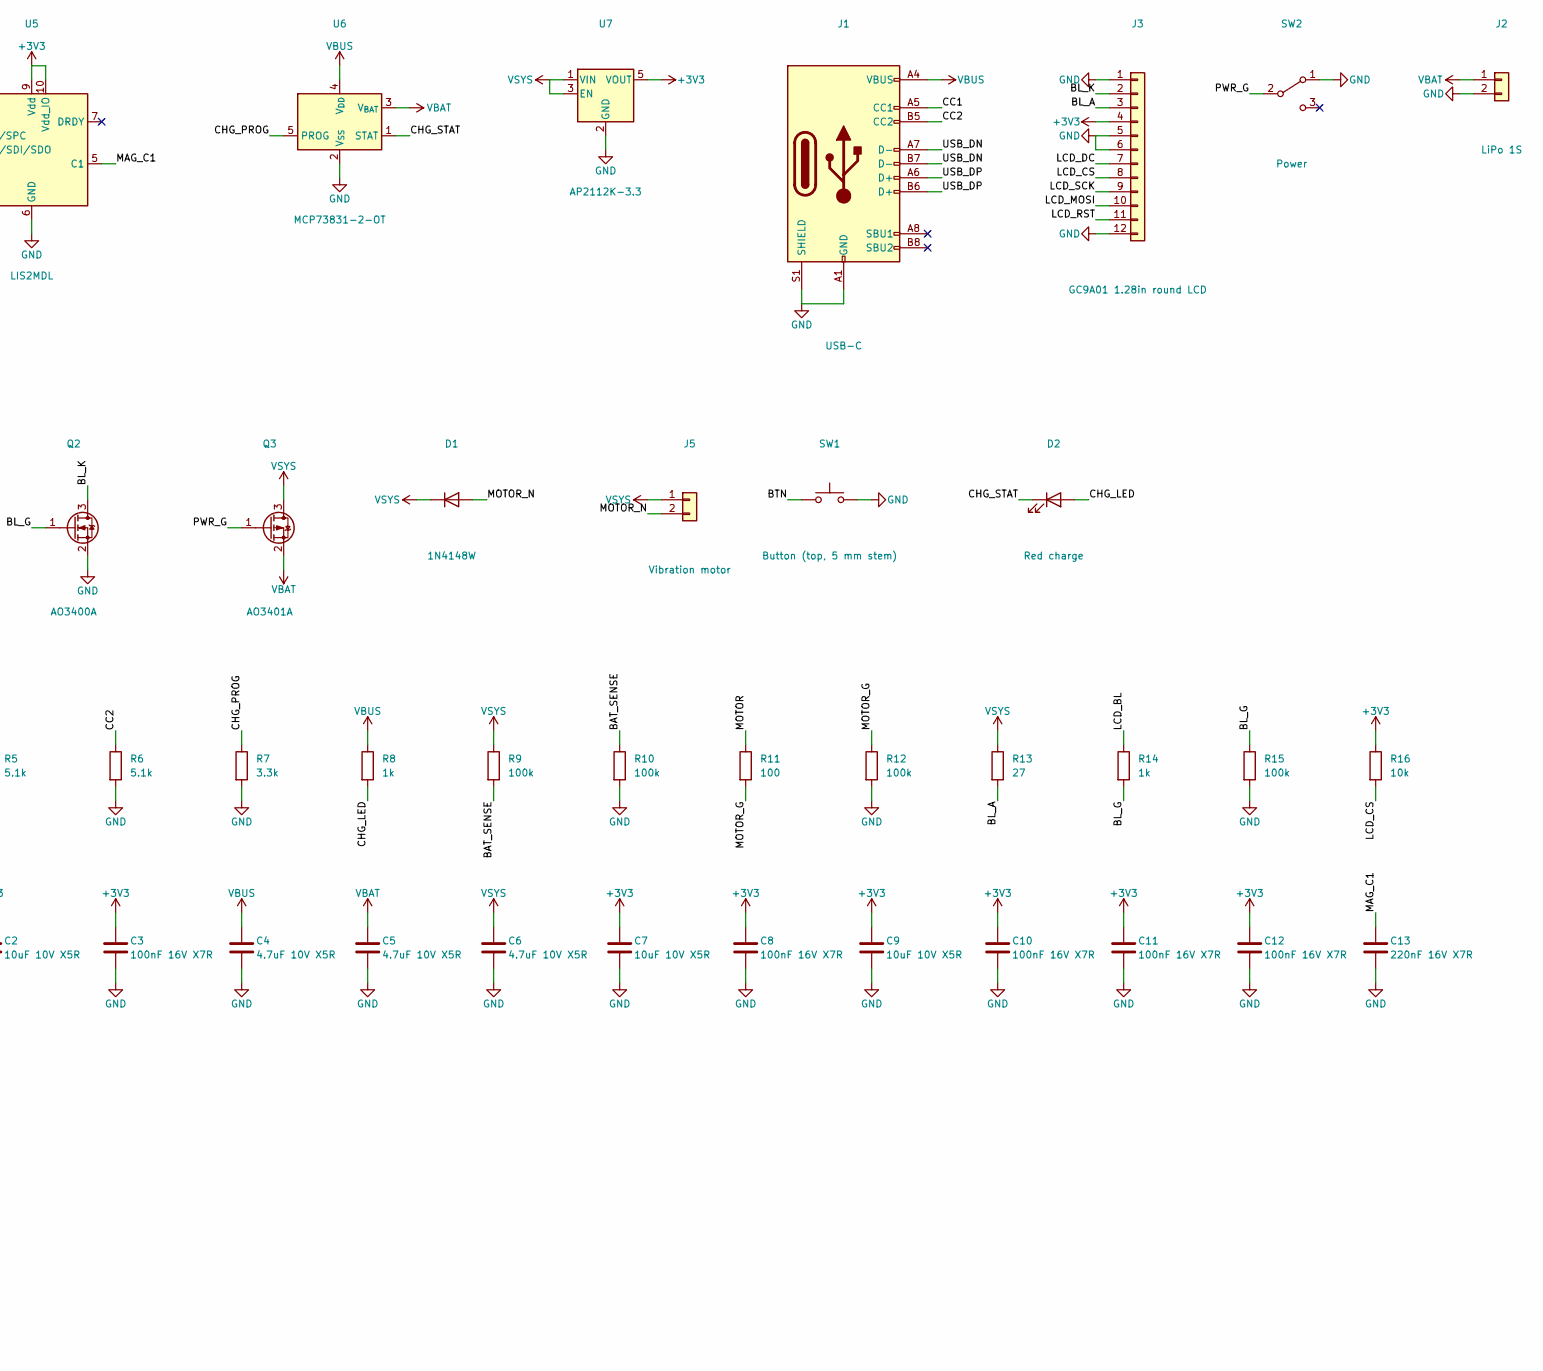
[picture p100: schematic finder_puck.kicad_sch, Finder Puck, part in row 1, column 2]

Parts:
C1: 1uF 10V X5R; C_0402_1005Metric
C2, C7, C9, C15: 10uF 10V X5R; C_0805_2012Metric
C3, C8, C10, C11, C12, C14, C16, C18, C19, C20, C21, C22: 100nF 16V X7R; C_0402_1005Metric
C4, C5, C6: 4.7uF 10V X5R; C_0603_1608Metric
C13: 220nF 16V X7R; C_0402_1005Metric
C17: 1uF 10V X5R; C_0603_1608Metric
D1: 1N4148W; D_SOD-123
D2: Red charge; LED_0603_1608Metric
H1, H2, H3, H4: M2.5; MountingHole_2.7mm_M2.5_Pad
H5: Motor lead; Hole_2.5mm_NPTH
J1: USB-C; USB_C_Receptacle_HRO_TYPE-C-31-M-12
J2: LiPo 1S; JST_PH_S2B-PH-SM4-TB_1x02-1MP_P2.00mm_Horizontal
J3: GC9A01 1.28in round LCD; LCD_FPC_12P_P0.70mm_Solder
J4: U.FL 915MHz; U.FL_Hirose_U.FL-R-SMT-1_Vertical
J5: Vibration motor; JST_SH_SM02B-SRSS-TB_1x02-1MP_P1.00mm_Horizontal
LED1, LED2, LED3, LED4: WS2812B-2020; LED_WS2812B-2020_PLCC4_2.0x2.0mm
Q1, Q2: AO3400A; SOT-23
Q3: AO3401A; SOT-23
R1, R2, R16, R17, R23: 10k; R_0402_1005Metric
R3, R4: 4.7k; R_0402_1005Metric
R5, R6: 5.1k; R_0402_1005Metric
R7: 3.3k; R_0402_1005Metric
R8, R14: 1k; R_0402_1005Metric
R9, R10, R12, R15, R20, R22, R25: 100k; R_0402_1005Metric
R11: 100; R_0402_1005Metric
R13: 27; R_0805_2012Metric
R18, R19: 33; R_0402_1005Metric
R21, R26: 150k; R_0402_1005Metric
R24: 220; R_0402_1005Metric
SW1: Button (top, 5 mm stem); SW_SPST_PTS645
SW2: Power; SW_SPDT_PCM12
TP1: U0TXD; TestPoint_Pad_D1.0mm
TP2: U0RXD; TestPoint_Pad_D1.0mm
U1: ESP32-S3-WROOM-1-N8; ESP32-S3-WROOM-1
U2: RFM95W-915S2; HOPERF_RFM9XW_SMD
U3: SAM-M10Q; ublox_SAM-M8Q
U4: LIS3DH; LGA-16_3x3mm_P0.5mm_LayoutBorder3x5y
U5: LIS2MDL; LGA-12_2x2mm_P0.5mm
U6: MCP73831-2-OT; SOT-23-5
U7: AP2112K-3.3; SOT-23-5

Connections:
+3V3: C2.1, C3.1, C7.1, C8.1, C9.1, C10.1, C11.1, C12.1, C17.1, C18.1, J3.4, R1.1, R2.1, R3.1, R4.1, R16.1, R17.1, R23.1, U1.2 (3V3), U2.13 (3.3V), U3.2 (VCC_IO), U3.3 (V_BCKP), U3.17 (VCC), U4.1 (VDD_IO), U4.8 (CS), U4.14 (VDD), U5.3 (~CS), U5.9 (Vdd), U5.10 (Vdd_IO), U7.5 (VOUT)
/BAT_SENSE: C14.1, R9.2, R10.1, U1.39 (IO1)
/BL_A: J3.3, R13.2
/BL_G: Q2.1 (G), R14.2, R15.1
/BL_K: J3.2, Q2.3 (D)
/BTN: R2.2, SW1.1, U1.27 (IO0)
/CC1: J1.A5 (CC1), R5.1
/CC2: J1.B5 (CC2), R6.1
/CHG_LED: D2.2 (A), R8.2
/CHG_PROG: R7.1, U6.5 (PROG)
/CHG_SENSE: R20.2, R21.1, U1.6 (IO6)
/CHG_STAT: D2.1 (K), R20.1, U6.1 (STAT)
/EN: C1.1, R1.2, U1.3 (EN)
/ESP_LCD_MOSI: R19.1, U1.34 (IO41)
/ESP_LCD_SCK: R18.1, U1.33 (IO40)
/ESP_LED: R24.1, U1.31 (IO38)
/GPS_RX: U1.10 (IO17), U3.14 (RXD)
/GPS_TX: U1.11 (IO18), U3.13 (TXD)
/IMU_INT: U1.38 (IO2), U4.11 (INT1)
/LCD_BL: R14.1, U1.25 (IO48)
/LCD_CS: J3.8, R16.2, U1.35 (IO42)
/LCD_DC: J3.7, U1.23 (IO21)
/LCD_MOSI: J3.10, R19.2
/LCD_RST: J3.11, R17.2, U1.24 (IO47)
/LCD_SCK: J3.9, R18.2
/LED_D1: LED1.1 (DOUT), LED2.3 (DIN)
/LED_D2: LED2.1 (DOUT), LED3.3 (DIN)
/LED_D3: LED3.1 (DOUT), LED4.3 (DIN)
/LED_DIN: LED1.3 (DIN), R24.2
/LORA_ANT: J4.1 (In), U2.9 (ANT)
/LORA_DIO0: U1.4 (IO4), U2.14 (DIO0)
/LORA_DIO1: U1.5 (IO5), U2.15 (DIO1)
/LORA_MISO: U1.21 (IO13), U2.2 (MISO)
/LORA_MOSI: U1.19 (IO11), U2.3 (MOSI)
/LORA_NSS: R23.2, U1.18 (IO10), U2.5 (NSS)
/LORA_RST: U1.22 (IO14), U2.6 (RESET)
/LORA_SCK: U1.20 (IO12), U2.4 (SCK)
/MAG_C1: C13.1, U5.5 (C1)
/MOTOR: R11.1, U1.7 (IO7)
/MOTOR_G: Q1.1 (G), R11.2, R12.1
/MOTOR_N: D1.2 (A), J5.2, Q1.3 (D)
/PWR_G: Q3.1 (G), R22.2, SW2.2 (B)
/SCL: R4.2, U1.17 (IO9), U4.4 (SCL/SPC), U5.1 (SCL/SPC)
/SDA: R3.2, U1.12 (IO8), U4.6 (SDA/SDI/SDO), U5.4 (SDA/SDI/SDO)
/U0RXD: TP2.1, U1.36 (RXD0)
/U0TXD: TP1.1, U1.37 (TXD0)
/USB_DN: J1.A7 (D-), J1.B7 (D-), U1.13 (IO19/USB_D-)
/USB_DP: J1.A6 (D+), J1.B6 (D+), U1.14 (IO20/USB_D+)
/VBUS_SENSE: R25.2, R26.1, U1.8 (IO15)
GND: C1.2, C2.2, C3.2, C4.2, C5.2, C6.2, C7.2, C8.2, C9.2, C10.2, C11.2, C12.2, C13.2, C14.2, C15.2, C16.2, C17.2, C18.2, C19.2, C20.2, C21.2, C22.2, H1.1, H2.1, H3.1, H4.1, J1.A1 (GND), J1.A12 (GND), J1.B1 (GND), J1.B12 (GND), J1.S1 (SHIELD), J2.2, J3.1, J3.5, J3.6, J3.12, J4.2 (Ext), LED1.2 (GND), LED2.2 (GND), LED3.2 (GND), LED4.2 (GND), Q1.2 (S), Q2.2 (S), R5.2, R6.2, R7.2, R10.2, R12.2, R15.2, R21.2, R26.2, SW1.2, SW2.1 (A), U1.1 (GND), U1.40 (GND), U1.41 (GND), U2.1 (GND), U2.8 (GND), U2.10 (GND), U3.1 (GND), U3.4 (GND), U3.5 (GND), U3.6 (GND), U3.10 (GND), U3.11 (GND), U3.15 (GND), U3.16 (GND), U3.20 (GND), U4.5 (GND), U4.7 (SDO/SA0), U4.10 (GND), U4.12 (GND), U5.6 (GND), U5.8 (GND), U6.2 (V_{SS}), U7.2 (GND)
VBAT: C5.1, J2.1, Q3.2 (S), R22.1, U6.3 (V_{BAT})
VBUS: C4.1, J1.A4 (VBUS), J1.A9 (VBUS), J1.B4 (VBUS), J1.B9 (VBUS), R8.1, R25.1, U6.4 (V_{DD})
VSYS: C6.1, C15.1, C16.1, C19.1, C20.1, C21.1, C22.1, D1.1 (K), J5.1, LED1.4 (VDD), LED2.4 (VDD), LED3.4 (VDD), LED4.4 (VDD), Q3.3 (D), R9.1, R13.1, U7.1 (VIN), U7.3 (EN)

Notes on the sheet:
FINDER PUCK ESP32-S3 swaps GPS positions with its partner over LoRa (RFM95W, 915 MHz), reads heading from LIS2MDL + LIS3DH, and draws a radar arrow and distance on a 1.28in round GC9A01 LCD (J3). LCD: own SPI host, SCK IO40, MOSI IO41, CS IO42, D/C IO21, RST IO47, backlight PWM IO48 -> Q2. LED1-LED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

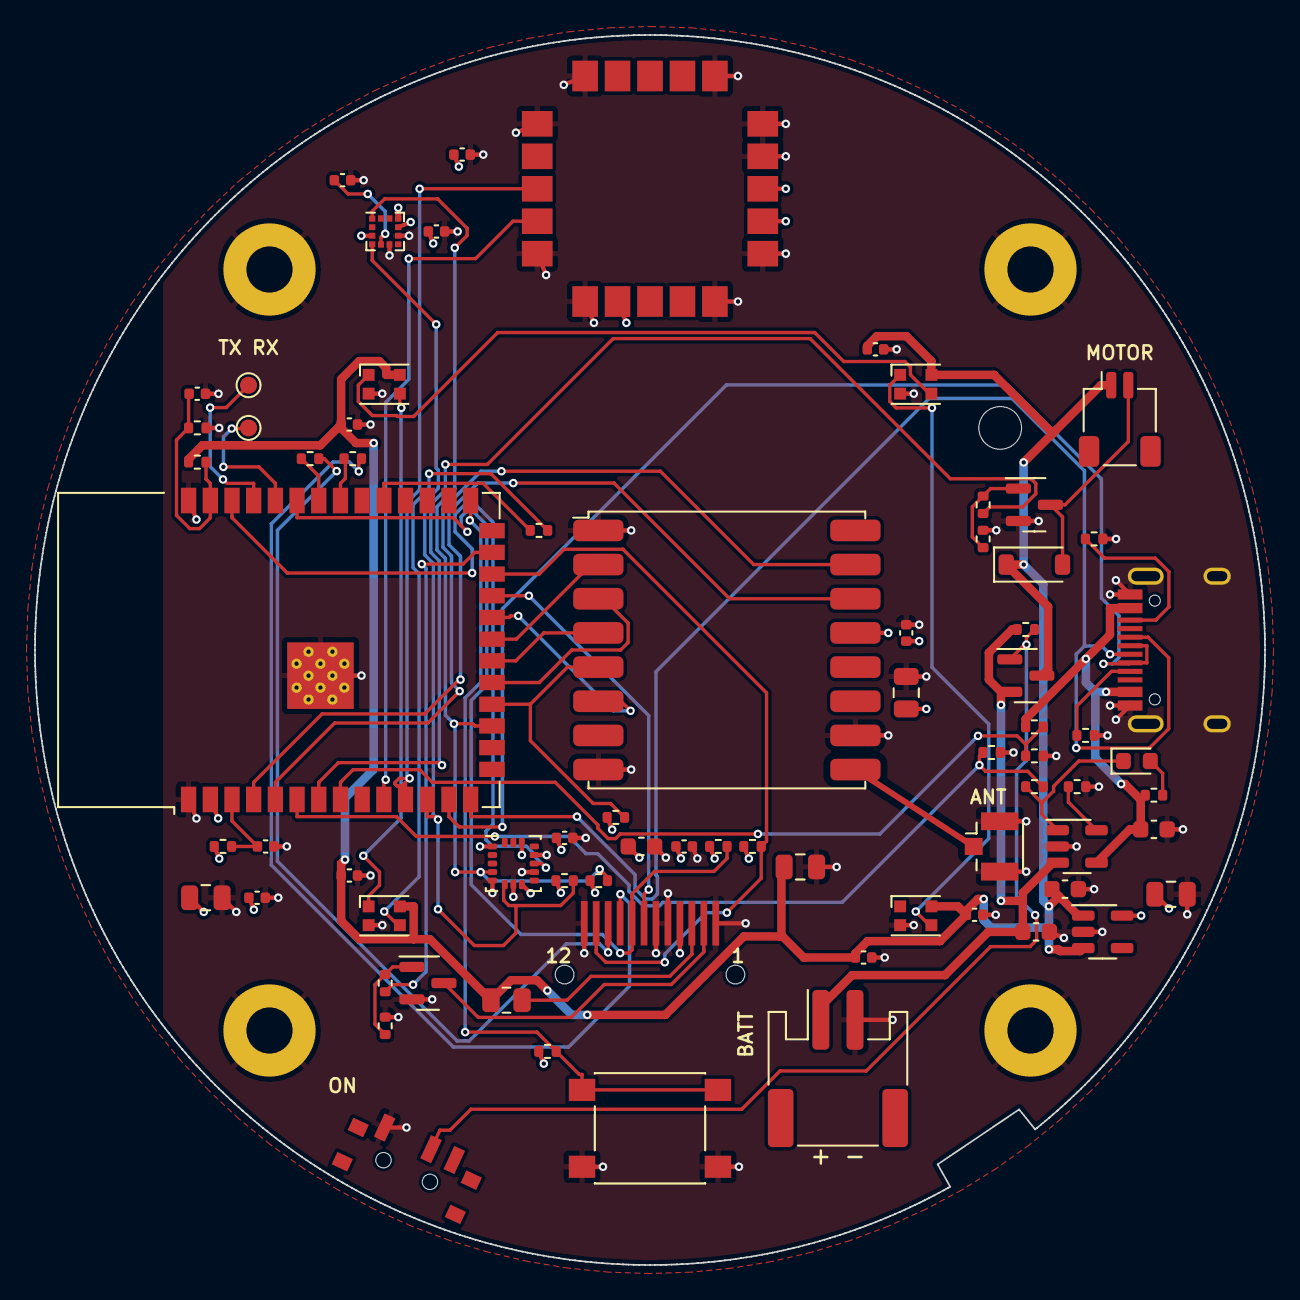
[picture p101: board finder_puck.kicad_pcb from above]

Board: 4 copper layers, 72.0 x 72.0 mm, 78 parts (0 on the bottom side), 53 nets.
