lucy-chapar/finder-puck/(commit log)

2026-10-23 Finder Puck: split out of evil-weather-machine
    The puck lived inside evil-weather-machine as two git-ignored local folders
    (puck/ and firmware/puck/). It is now its own repo: the KiCad project,
    generators, case, build guide and fab files at the root, the ESP32-S3
    firmware in firmware/.
    - tools/kicad_helpers.py is the carrier-board generator from
    evil-weather-machine (pcb/tools/generate_kicad.py at 8a2b1d7), vendored
    for its KiCad helpers. Running it directly is refused.
    - Paths in regen.sh, the case, guide and model scripts, both READMEs and the
    guide's cover and back page now match the new layout.
    - CLAUDE.md carries the build notes from the old folder's local file, plus
    the ERC pr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
2026-10-23 Seal the case to IP55 (case-only)
    Every path into the case now ends at a seal: a 1.0 mm closed-cell foam
    seal squeezed to 0.6 mm between the shell rim and a 1.5 mm plate skirt
    (the lap lip moves inboard to make room), tethered TPU plugs for the
    USB-C opening and the switch slot (which now stays below the rim), a
    9 x 1 O-ring on the button cap in a sleeve under the skin, nylon washers
    under the bolt heads, and UV resin round the crystal, the bezel and the
    charge-LED pinhole.
    build_case.py models the plugs, seal, O-ring and washers, checks them,
    and reports the plugs' designed 0.1 mm press fit as "squeeze" lines.
    The build guide, previews and README follow. Generated outputs (STLs,
    FCStd, STE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
2026-10-23 Regenerate case, previews and build guide for the IP55 seals
2026-10-23 regen.sh: show the plugs' squeeze lines and any CHECK in the case build output
    Claude-Session: https://claude.ai/code/session_01YWJ23TfjSuGD4wzkfAMwDt
2026-10-23 Replace the USB-C plug with a sliding door
    A curved door slides 24.5 degrees round the wall in a flush pocket, held
    by tongues in a shell groove and a plate groove. A die-cut 0.5 mm foam
    frame on its inside clears the pocket floor while it slides and is
    squeezed 40 % on a raised land (lead-in step at both ends) round the
    opening when shut. build_case.py also checks the door slid open.
    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
2026-10-23 Seal the lid with clamped gaskets instead of UV resin
    The face rises from Z 8.0 to 8.6 (the puck is 18.3 mm thick) so every lid seal
    is a bolted die-cut gasket and nothing is glued:
    - a 0.3 mm foam ring between the crystal's edge and the bezel lip
    - the bezel flange now runs all the way round (0.2 mm over a 6.8 mm GPS
    module) and clamps a die-cut lid gasket under the plate's pocket ceiling,
    with a lobe round the button bore and a tab round the charge LED
    - the button sleeve moves from the plate to the bezel's lobe, so the cap goes
    on before the bezel
    - the charge-LED pinhole becomes a light pipe on the bezel
    - the index hole is blind (0.3 mm of skin under the stub)
    build_case.py mode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
2026-10-23 Regenerate case, previews and build guide for the door and lid gaskets
    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
2026-10-23 Machine the shell from black anodised aluminium, with a plastic antenna window
    The shell becomes CNC-machined 6061, black anodised, drawn for a 3-axis mill in
    three setups with no undercuts: the bay is a smaller bore under the board's
    (the step is the ledge), the bosses run into its wall with 1.5 mm radii, the
    bolts go into tapped M2.5 holes instead of heat-set inserts, the lap lip and
    the 45 degree overhangs are gone, slots have cutter-sized corner radii.
    Aluminium would block both radios, so the plate stays plastic over the GPS
    patch, and between 12 and 4 o'clock the shell's wall is cut down to the floor
    (60 degree flanks) and filled by a printed window part that carries the LoRa
    flex ant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
2026-10-24 Shell DFM pass for 3-axis milling; engrave the logo as a V-groove contour
    - The window's clockwise flank sliced through the bolt boss at 315 degrees, leaving
    a remnant no single flank pass could cut. The notch now ends at -14 degrees
    (3 o'clock) and the USB-C door slides open counter-clockwise, so that boss
    stays whole in the wall.
    - The battery cable slot ran 0.3 mm past the board's bore under the rim, an
    undercut. It now stops at the bore and the ledge, with 1.5 mm corners.
    - The lanyard's back hole stops 1 mm above the side hole's axis, so its drill
    point is 0.7 mm under the boss top instead of 0.2 mm.
    - The OSHW logo is a 90 degree V-groove along its outline, 0.3 mm deep and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
2026-10-28 Shop files for the shell quote and the gasket converter
    - case/shop_drawing.py (freecadcmd, after build_case.py) writes the shell and the
    window as single-part STEPs in a shop frame (origin on the axis at the back face),
    an A3 drawing of the shell (top, back, section and side views, numbered features
    with sizes and tolerances, threads, finish, setups) as SVG and PDF, and the flat
    gaskets as a DXF with a layer per foam thickness.
    - regen.sh runs it after the case build.
    - README: which files go to the shop; the seal faces stay anodised (only the
    threads are masked or chased); "Sourcing the seals" with foam grades and sources.
    - README: the lid gasket and the foam ring under the ring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
